attilabody/cardetector/hardware/kicad/328p-au/cardetector_328p-au.kicad_pcb

## KiCad design hardware/kicad/328p-au/cardetector_328p-au.kicad_pcb (2018-04-12)

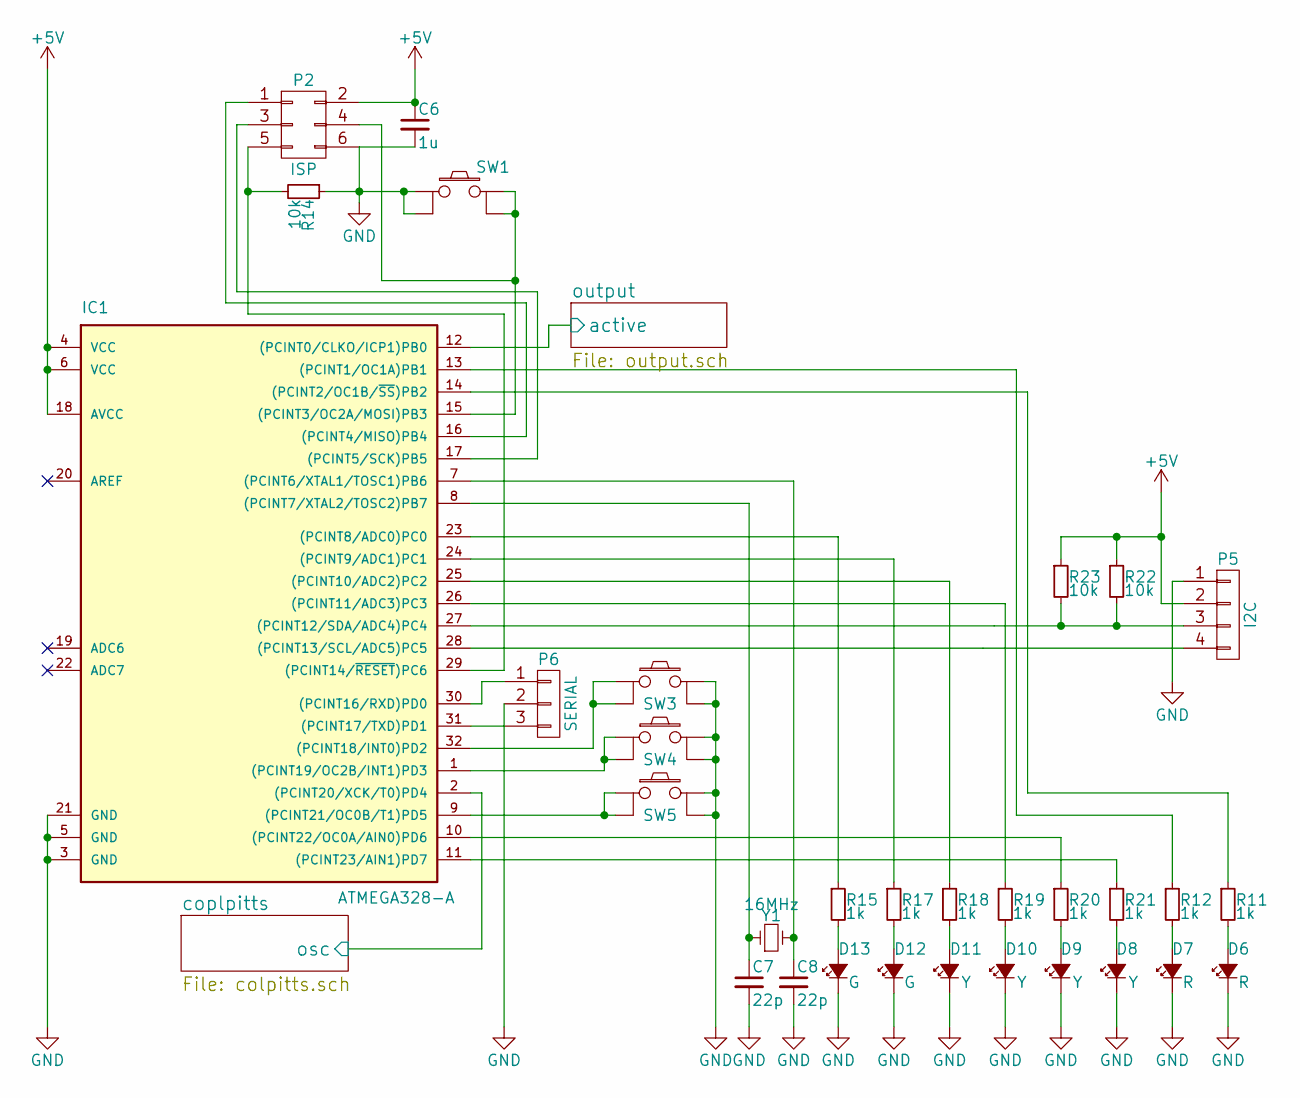
[picture p1: schematic cardetector_328p-au.sch]

Parts:
C6: 1u; C_0603_HandSoldering
C7, C8: 22p; C_0603_HandSoldering
D6, D7: R; SOD80C
D8, D9, D10, D11: Y; SOD80C
D12, D13: G; SOD80C
IC1: ATMEGA328-A; TQFP-32_7x7mm_Pitch0.8mm
P2: ISP; Socket_Strip_Straight_2x03
P5: I2C; Pin_Header_Straight_1x04
P6: SERIAL; Pin_Header_Straight_1x03
R11, R12, R15, R17, R18, R19, R20, R21: 1k; R_0603_HandSoldering
R14, R22, R23: 10k; R_0603_HandSoldering
SW1, SW3, SW4, SW5: TACTILE_SW; SW_TH_Tactile_Omron_B3F-10xx
Y1: 16MHz; Crystal_HC49-U_Vertical

Connections:
+5V: C6.1, IC1.4 (VCC), IC1.6 (VCC), IC1.18 (AVCC), P2.2, P5.2, R22.1, R23.1; also elsewhere on the board
/coplpitts/osc: IC1.2 ((PCINT20/XCK/T0)PD4); also elsewhere on the board
/output/active: IC1.12 ((PCINT0/CLKO/ICP1)PB0); also elsewhere on the board
GND: C6.2, C7.2, C8.2, D6.1 (K), D7.1 (K), D8.1 (K), D9.1 (K), D10.1 (K), D11.1 (K), D12.1 (K), D13.1 (K), IC1.3 (GND), IC1.5 (GND), IC1.21 (GND), P2.6, P5.1, P6.2, R14.1, SW1.1, SW1.2, SW3.3, SW3.4, SW4.3, SW4.4, SW5.3, SW5.4; also elsewhere on the board
unnamed: C7.1, IC1.8 ((PCINT7/XTAL2/TOSC2)PB7), Y1.1
unnamed: C8.1, IC1.7 ((PCINT6/XTAL1/TOSC1)PB6), Y1.2
unnamed: D6.2 (A), R11.2
unnamed: D7.2 (A), R12.2
unnamed: D8.2 (A), R21.2
unnamed: D9.2 (A), R20.2
unnamed: D10.2 (A), R19.2
unnamed: D11.2 (A), R18.2
unnamed: D12.2 (A), R17.2
unnamed: D13.2 (A), R15.2
unnamed: IC1.1 ((PCINT19/OC2B/INT1)PD3), SW4.1, SW4.2
unnamed: IC1.9 ((PCINT21/OC0B/T1)PD5), SW5.1, SW5.2
unnamed: IC1.10 ((PCINT22/OC0A/AIN0)PD6), R20.1
unnamed: IC1.11 ((PCINT23/AIN1)PD7), R21.1
unnamed: IC1.13 ((PCINT1/OC1A)PB1), R12.1
unnamed: IC1.14 ((PCINT2/OC1B/~SS~)PB2), R11.1
unnamed: IC1.16 ((PCINT4/MISO)PB4), P2.1
unnamed: IC1.17 ((PCINT5/SCK)PB5), P2.3
unnamed: IC1.23 ((PCINT8/ADC0)PC0), R15.1
unnamed: IC1.24 ((PCINT9/ADC1)PC1), R17.1
unnamed: IC1.25 ((PCINT10/ADC2)PC2), R18.1
unnamed: IC1.26 ((PCINT11/ADC3)PC3), R19.1
unnamed: IC1.27 ((PCINT12/SDA/ADC4)PC4), P5.3, R22.2, R23.2
unnamed: IC1.28 ((PCINT13/SCL/ADC5)PC5), P5.4
unnamed: IC1.30 ((PCINT16/RXD)PD0), P6.1
unnamed: IC1.31 ((PCINT17/TXD)PD1), P6.3
unnamed: IC1.32 ((PCINT18/INT0)PD2), SW3.1, SW3.2

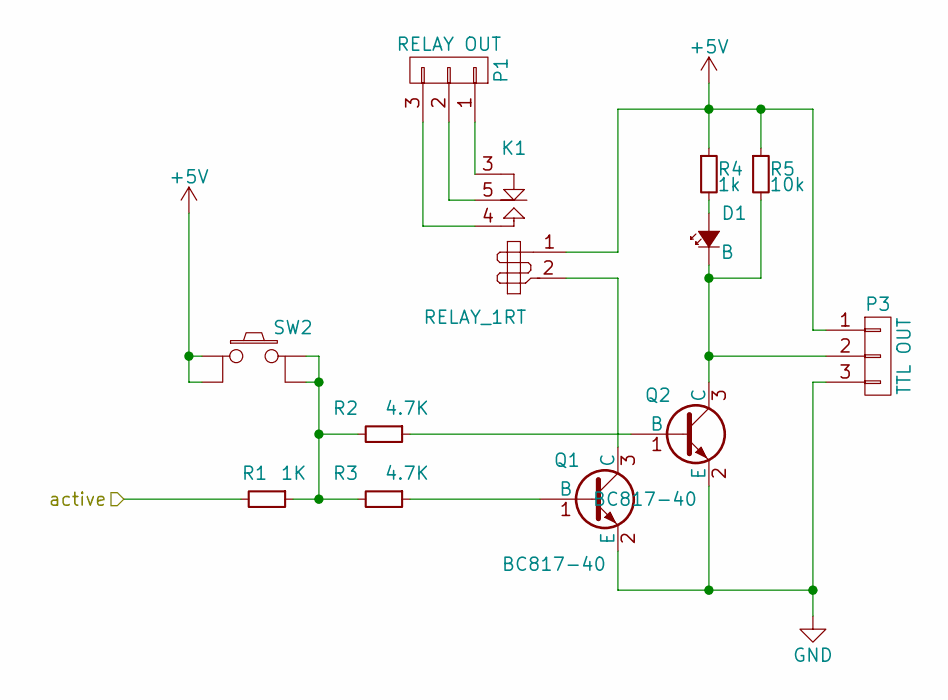
[picture p2: schematic output.sch]

Parts:
D1: B; SOD80C
K1: RELAY_1RT; SRD-SL-C
P1: RELAY OUT; W237-133
P3: TTL OUT; Pin_Header_Straight_1x03
Q1, Q2: BC817-40; SOT-23
R1: 1K; R_0603_HandSoldering
R2, R3: 4.7K; R_0603_HandSoldering
R4: 1k; R_0603_HandSoldering
R5: 10k; R_0603_HandSoldering
SW2: TACTILE_SW; SW_TH_Tactile_Omron_B3F-10xx

Connections:
+5V: K1.1, P3.1, R4.1, R5.1, SW2.1, SW2.2; also elsewhere on the board
/output/active: R1.2; also elsewhere on the board
GND: P3.3, Q1.2 (E), Q2.2 (E); also elsewhere on the board
unnamed: D1.1 (K), P3.2, Q2.3 (C), R5.2
unnamed: D1.2 (A), R4.2
unnamed: K1.2, Q1.3 (C)
unnamed: K1.3 (R1), P1.1
unnamed: K1.4 (T1), P1.3
unnamed: K1.5 (C1), P1.2
unnamed: Q1.1 (B), R3.1
unnamed: Q2.1 (B), R2.1
unnamed: R1.1, R2.2, R3.2, SW2.3, SW2.4

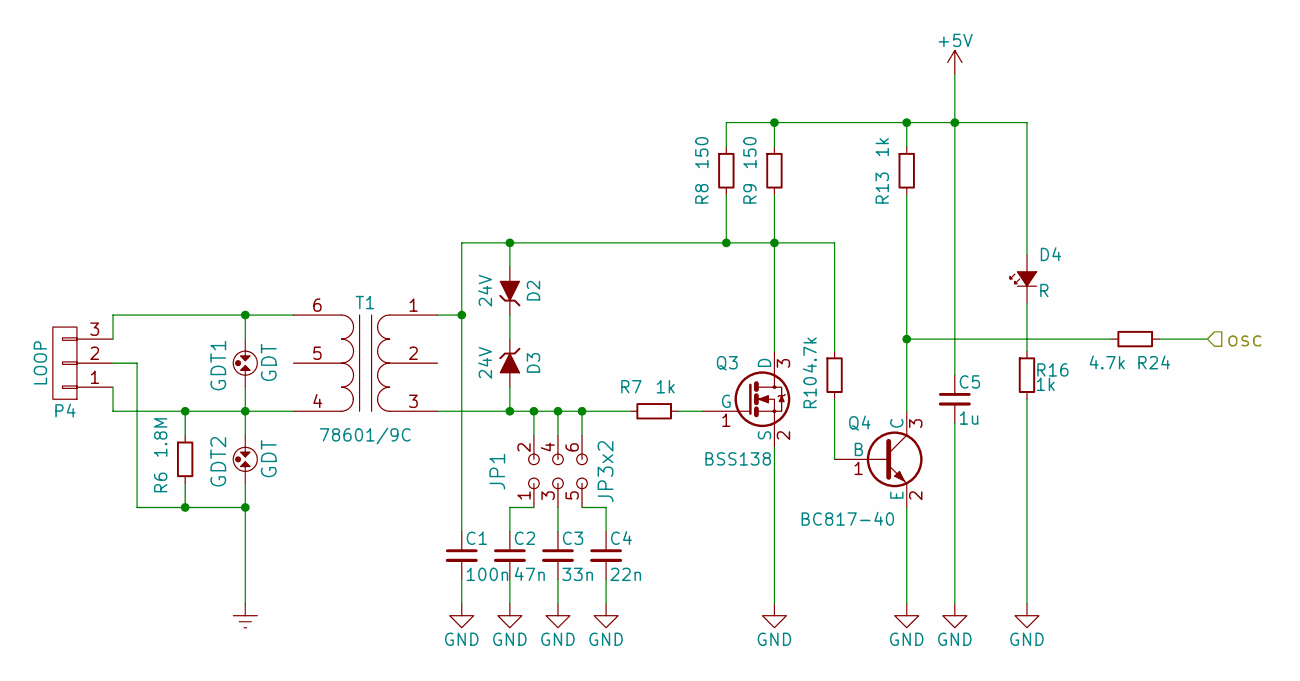
[picture p3: schematic colpitts.sch]

Parts:
C1: 100n; C_0603_HandSoldering
C2: 47n; C_0603_HandSoldering
C3: 33n; C_0603_HandSoldering
C4: 22n; C_0603_HandSoldering
C5: 1u; C_0603_HandSoldering
D2, D3: 24V; SOD80C
D4: R; SOD80C
GDT1, GDT2: GDT; CG5350L
JP1: JP3x2; Pin_Header_Straight_2x03
P4: LOOP; W237-133
Q3: BSS138; SOT-23
Q4: BC817-40; SOT-23
R6: 1.8M; R_0603_HandSoldering
R7, R13, R16: 1k; R_0603_HandSoldering
R8, R9: 150; R_0603_HandSoldering
R10, R24: 4.7k; R_0603_HandSoldering
T1: 78601/9C; 78601_9C

Connections:
+5V: C5.1, D4.2 (A), R8.1, R9.1, R13.1; also elsewhere on the board
/coplpitts/osc: R24.1; also elsewhere on the board
Earth: GDT2.2, P4.2, R6.2
GND: C1.2, C2.2, C3.2, C4.2, C5.2, Q3.2 (S), Q4.2 (E), R16.2; also elsewhere on the board
unnamed: C1.1, D2.2 (A), Q3.3 (D), R8.2, R9.2, R10.1, T1.1 (AA)
unnamed: C2.1, JP1.1
unnamed: C3.1, JP1.3
unnamed: C4.1, JP1.5
unnamed: D2.1 (K), D3.1 (K)
unnamed: D3.2 (A), JP1.2, JP1.4, JP1.6, R7.2, T1.3 (AB)
unnamed: D4.1 (K), R16.1
unnamed: GDT1.1, P4.3, T1.6 (SB)
unnamed: GDT1.2, GDT2.1, P4.1, R6.1, T1.4 (SA)
unnamed: Q3.1 (G), R7.1
unnamed: Q4.1 (B), R10.2
unnamed: Q4.3 (C), R13.2, R24.2

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
Board: 2 copper layers, 66 parts (2 on the bottom side), 55 nets, no tracks yet.
