attilabody/cardetector/hardware/kicad/stm32f030/stm32f030.kicad_pcb

## KiCad design hardware/kicad/stm32f030/stm32f030.kicad_pcb (2018-04-12)

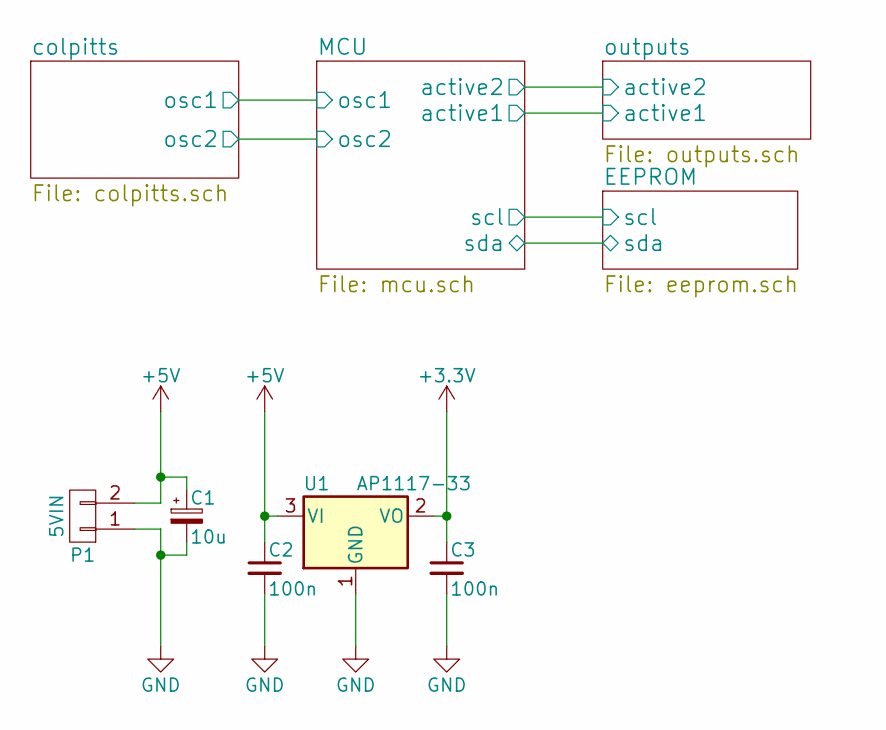
[picture p4: schematic stm32f030.sch]

Parts:
C1: 10u; Tantalum_Case-B_EIA-3528-21_Hand
C2, C3: 100n; C_0805_HandSoldering
P1: 5VIN; bornier2
U1: AP1117-33; SOT-223-3Lead_TabPin2

Connections:
+3V3: C3.1, U1.2 (VO); also elsewhere on the board
+5V: C1.1, C2.1, P1.2, U1.3 (VI); also elsewhere on the board
GND: C1.2, C2.2, C3.2, P1.1, U1.1 (GND); also elsewhere on the board

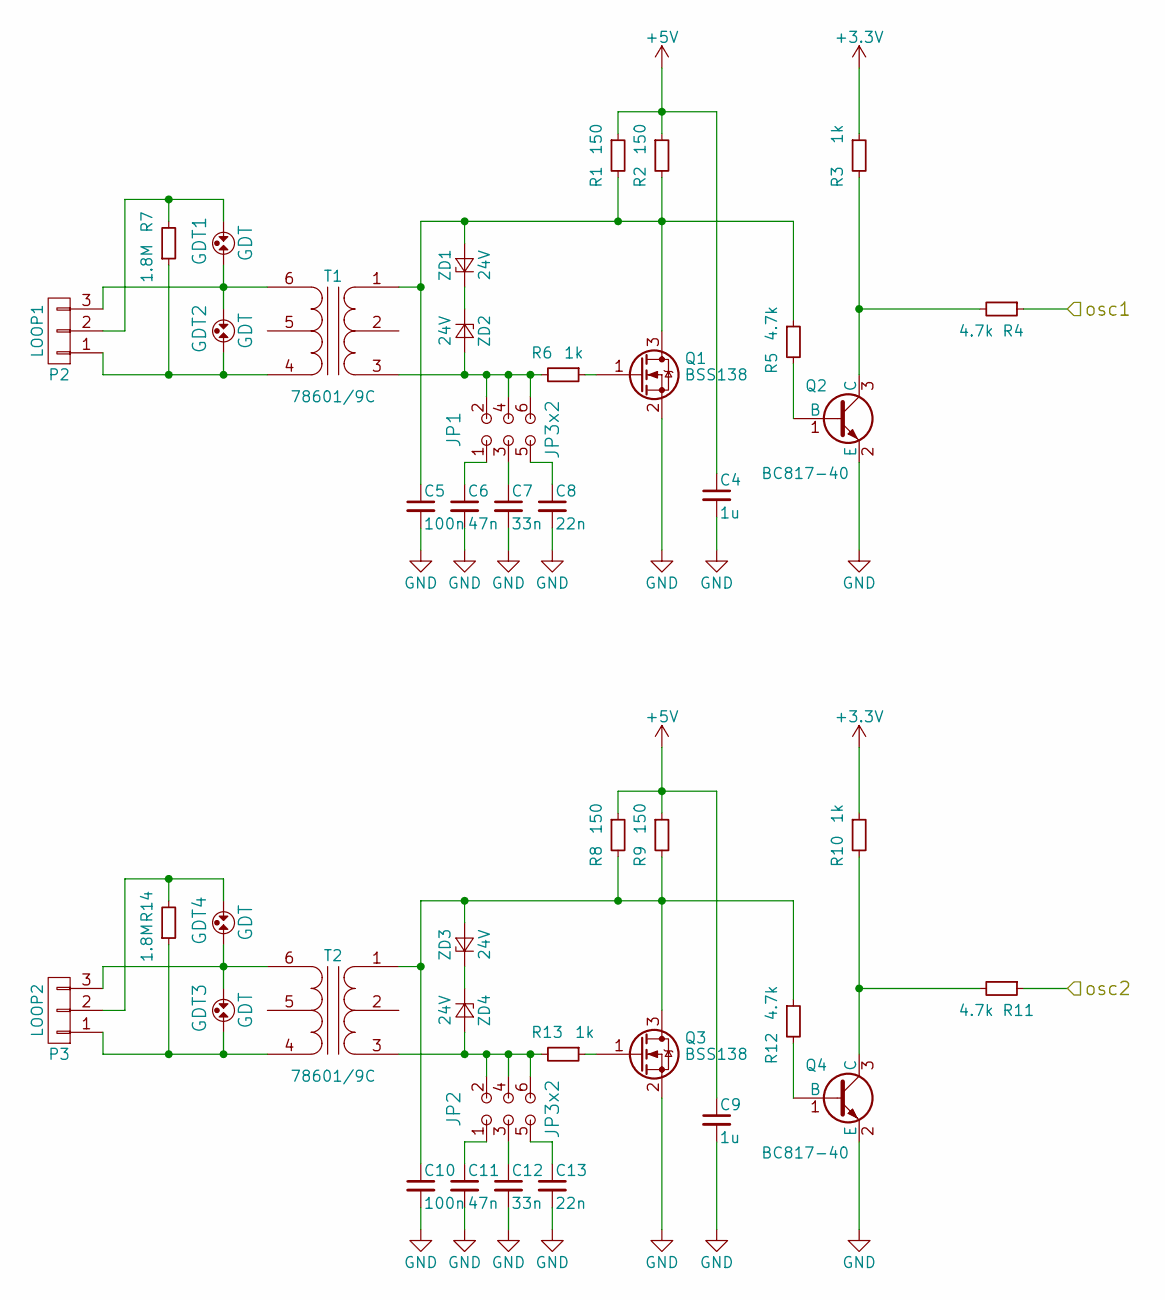
[picture p5: schematic colpitts.sch]

Parts:
C4, C9: 1u; C_1206_HandSoldering
C5, C10: 100n; C_1206_HandSoldering
C6, C11: 47n; C_1206
C7, C12: 33n; C_0805_HandSoldering
C8, C13: 22n; C_0805_HandSoldering
GDT1, GDT2, GDT3, GDT4: GDT
JP1, JP2: JP3x2; Pin_Header_Straight_2x03_Pitch2.54mm
P2: LOOP1; bornier3
P3: LOOP2; bornier3
Q1, Q3: BSS138; SOT-23
Q2, Q4: BC817-40; SOT-23
R1, R2, R8, R9: 150; R_0805
R3, R6, R10, R13: 1k; R_0603_HandSoldering
R4, R5, R11, R12: 4.7k; R_0603_HandSoldering
R7, R14: 1.8M; R_0603_HandSoldering
T1, T2: 78601/9C; Murata_Impulse_Transformer
ZD1, ZD2, ZD3, ZD4: 24V; D_MiniMELF_Standard

Connections:
+3V3: R3.1, R10.1; also elsewhere on the board
+5V: C4.1, C9.1, R1.1, R2.1, R8.1, R9.1; also elsewhere on the board
/MCU/osc1: R4.1; also elsewhere on the board
/MCU/osc2: R11.1; also elsewhere on the board
GND: C4.2, C5.2, C6.2, C7.2, C8.2, C9.2, C10.2, C11.2, C12.2, C13.2, Q1.2 (S), Q2.2 (E), Q3.2 (S), Q4.2 (E); also elsewhere on the board
unnamed: C5.1, Q1.3 (D), R1.2, R2.2, R5.1, T1.1 (AA), ZD1.2 (A)
unnamed: C6.1, JP1.1
unnamed: C7.1, JP1.3
unnamed: C8.1, JP1.5
unnamed: C10.1, Q3.3 (D), R8.2, R9.2, R12.1, T2.1 (AA), ZD3.2 (A)
unnamed: C11.1, JP2.1
unnamed: C12.1, JP2.3
unnamed: C13.1, JP2.5
unnamed: GDT1.1, GDT2.2, P2.3, T1.6 (SB)
unnamed: GDT1.2, P2.2, R7.2
unnamed: GDT2.1, P2.1, R7.1, T1.4 (SA)
unnamed: GDT3.1, P3.1, R14.1, T2.4 (SA)
unnamed: GDT3.2, GDT4.1, P3.3, T2.6 (SB)
unnamed: GDT4.2, P3.2, R14.2
unnamed: JP1.2, JP1.4, JP1.6, R6.2, T1.3 (AB), ZD2.2 (A)
unnamed: JP2.2, JP2.4, JP2.6, R13.2, T2.3 (AB), ZD4.2 (A)
unnamed: Q1.1 (G), R6.1
unnamed: Q2.1 (B), R5.2
unnamed: Q2.3 (C), R3.2, R4.2
unnamed: Q3.1 (G), R13.1
unnamed: Q4.1 (B), R12.2
unnamed: Q4.3 (C), R10.2, R11.2
unnamed: ZD1.1 (K), ZD2.1 (K)
unnamed: ZD3.1 (K), ZD4.1 (K)

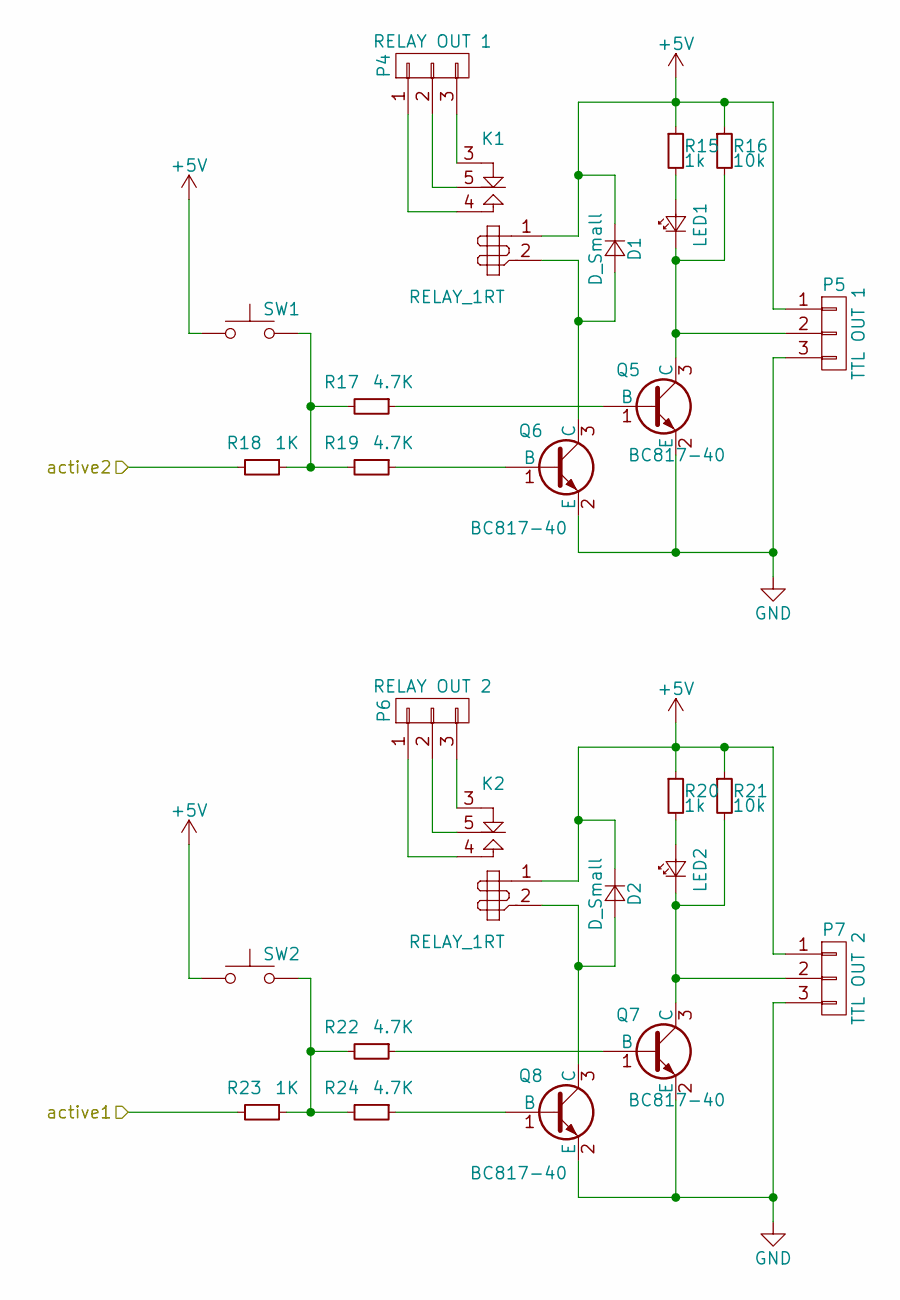
[picture p6: schematic outputs.sch]

Parts:
D1, D2: D_Small; D_MiniMELF_Standard
K1, K2: RELAY_1RT; SRD-SL-C
LED1, LED2: LED_Small; LED_0805
P4: RELAY OUT 1; bornier3
P5: TTL OUT 1; Pin_Header_Straight_1x03_Pitch2.54mm
P6: RELAY OUT 2; bornier3
P7: TTL OUT 2; Pin_Header_Straight_1x03_Pitch2.54mm
Q5, Q6, Q7, Q8: BC817-40; SOT-23_Handsoldering
R15, R20: 1k; R_0603_HandSoldering
R16, R21: 10k; R_0603_HandSoldering
R17, R19, R22, R24: 4.7K; R_0603_HandSoldering
R18, R23: 1K; R_0603_HandSoldering
SW1, SW2: SW_Push; TS_362

Connections:
+5V: D1.1 (K), D2.1 (K), K1.1, K2.1, P5.1, P7.1, R15.1, R16.1, R20.1, R21.1, SW1.1, SW2.1; also elsewhere on the board
/MCU/active1: R23.2; also elsewhere on the board
/MCU/active2: R18.2; also elsewhere on the board
GND: P5.3, P7.3, Q5.2 (E), Q6.2 (E), Q7.2 (E), Q8.2 (E); also elsewhere on the board
unnamed: D1.2 (A), K1.2, Q6.3 (C)
unnamed: D2.2 (A), K2.2, Q8.3 (C)
unnamed: K1.3 (R1), P4.3
unnamed: K1.4 (T1), P4.1
unnamed: K1.5 (C1), P4.2
unnamed: K2.3 (R1), P6.3
unnamed: K2.4 (T1), P6.1
unnamed: K2.5 (C1), P6.2
unnamed: LED1.1 (K), P5.2, Q5.3 (C), R16.2
unnamed: LED1.2 (A), R15.2
unnamed: LED2.1 (K), P7.2, Q7.3 (C), R21.2
unnamed: LED2.2 (A), R20.2
unnamed: Q5.1 (B), R17.1
unnamed: Q6.1 (B), R19.1
unnamed: Q7.1 (B), R22.1
unnamed: Q8.1 (B), R24.1
unnamed: R17.2, R18.1, R19.2, SW1.2
unnamed: R22.2, R23.1, R24.2, SW2.2

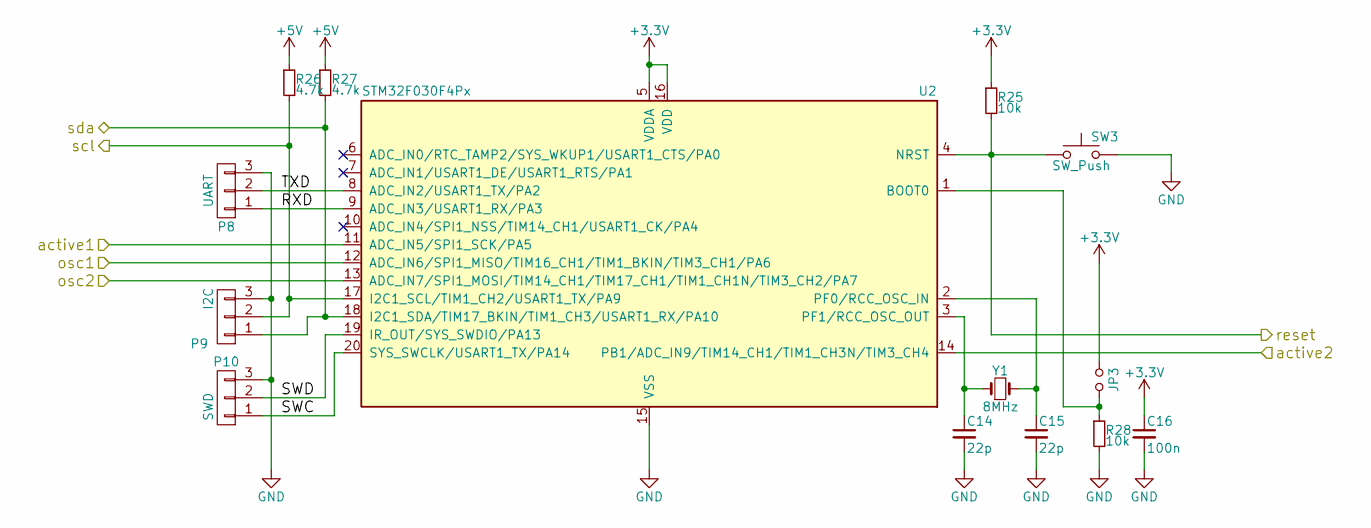
[picture p7: schematic mcu.sch]

Parts:
C14, C15: 22p; C_0603_HandSoldering
C16: 100n; C_0805_HandSoldering
JP3: boot0; Pin_Header_Straight_1x02_Pitch2.54mm
P8: UART; Pin_Header_Straight_1x03_Pitch2.54mm
P9: I2C; Pin_Header_Straight_1x03_Pitch2.54mm
P10: SWD; Pin_Header_Straight_1x03_Pitch2.54mm
R25, R28: 10k; R_0603_HandSoldering
R26, R27: 4.7k; R_0603_HandSoldering
SW3: SW_Push; TS_362
U2: STM32F030F4Px; TSSOP-20_4.4x6.5mm_Pitch0.65mm_Handsoldering
Y1: 8MHz; Crystal_HC49-4H_Vertical

Connections:
+3V3: C16.1, JP3.1, R25.1, U2.5 (VDDA), U2.16 (VDD); also elsewhere on the board
+5V: R26.1, R27.1; also elsewhere on the board
/EEPROM/scl: P9.2, R26.2, U2.17 (I2C1_SCL/TIM1_CH2/USART1_TX/PA9); also elsewhere on the board
/EEPROM/sda: P9.1, R27.2, U2.18 (I2C1_SDA/TIM17_BKIN/TIM1_CH3/USART1_RX/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); also elsewhere on the board
/MCU/RXD: P8.1, U2.9 (ADC_IN3/USART1_RX/PA3)
/MCU/SWC: P10.1, U2.20 (SYS_SWCLK/USART1_TX/PA14)
/MCU/SWD: P10.2, U2.19 (IR_OUT/SYS_SWDIO/PA13)
/MCU/TXD: P8.2, U2.8 (ADC_IN2/USART1_TX/PA2)
/MCU/active1: U2.11 (ADC_IN5/SPI1_SCK/PA5); also elsewhere on the board
/MCU/active2: U2.14 (PB1/ADC_IN9/TIM14_CH1/TIM1_CH3N/TIM3_CH4); also elsewhere on the board
/MCU/osc1: U2.12 (ADC_IN6/SPI1_MISO/TIM16_CH1/TIM1_BKIN/T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); also elsewhere on the board
/MCU/osc2: U2.13 (ADC_IN7/SPI1_MOSI/TIM14_CH1/TIM17_CH1/T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); also elsewhere on the board
/MCU/reset: R25.2, SW3.1, U2.4 (NRST)
GND: C14.2, C15.2, C16.2, P8.3, P9.3, P10.3, R28.2, SW3.2, U2.15 (VSS); also elsewhere on the board
unnamed: C14.1, U2.3 (PF1/RCC_OSC_OUT), Y1.1
unnamed: C15.1, U2.2 (PF0/RCC_OSC_IN), Y1.2
unnamed: JP3.2, R28.1, U2.1 (BOOT0)

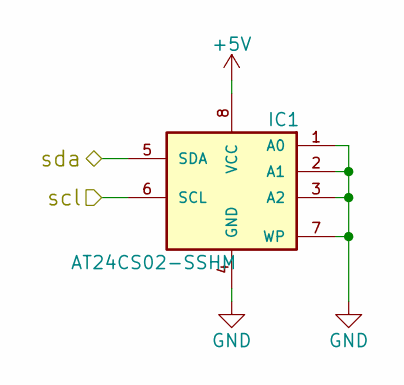
[picture p8: schematic eeprom.sch]

Parts:
IC1: AT24CS02-SSHM; SOIC-8_3.9x4.9mm_Pitch1.27mm

Connections:
+5V: IC1.8 (VCC); also elsewhere on the board
/EEPROM/scl: IC1.6 (SCL); also elsewhere on the board
/EEPROM/sda: IC1.5 (SDA); also elsewhere on the board
GND: IC1.1 (A0), IC1.2 (A1), IC1.3 (A2), IC1.4 (GND), IC1.7 (WP); also elsewhere on the board

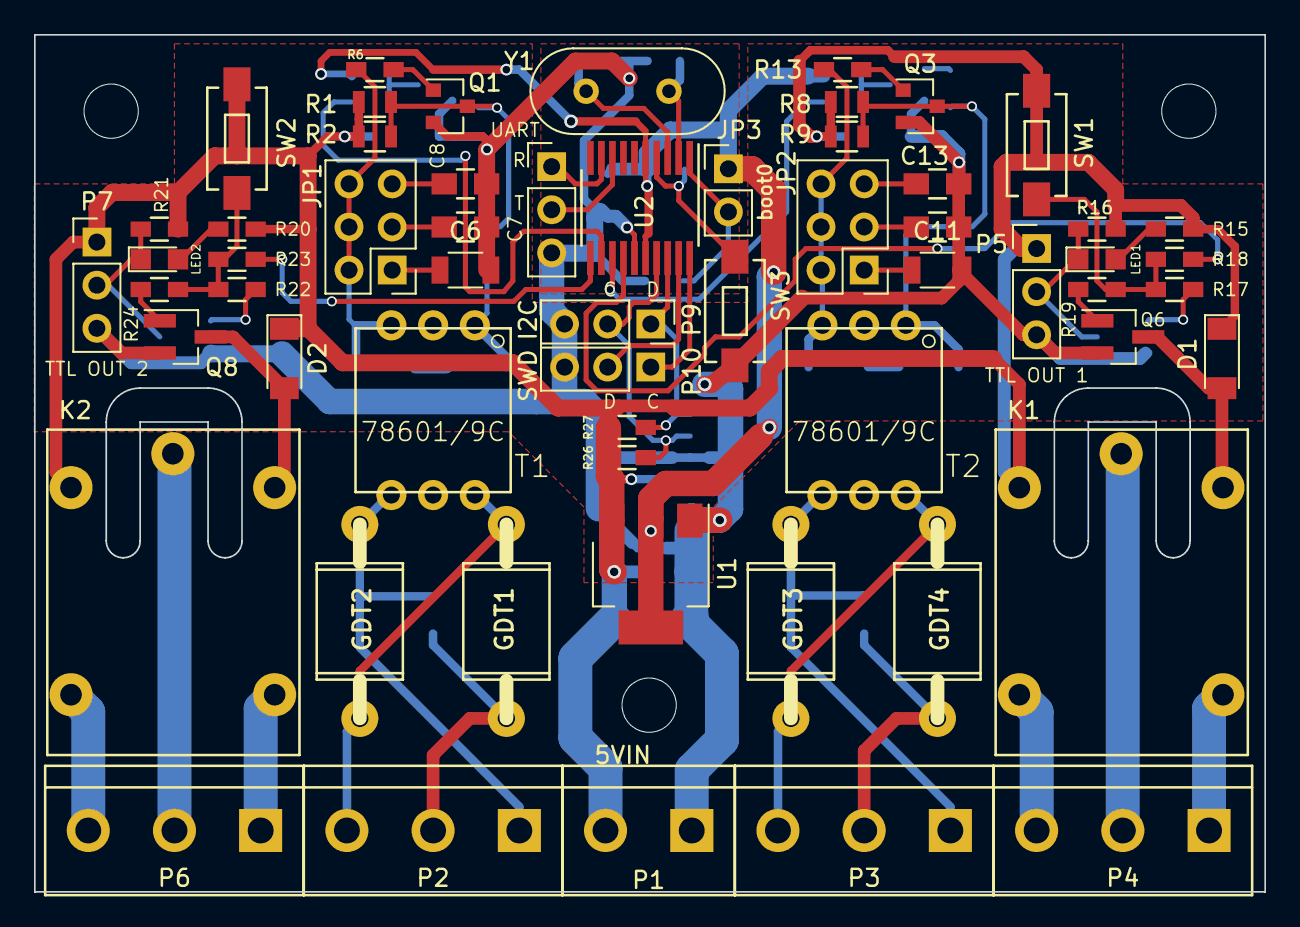
[picture p9: board stm32f030.kicad_pcb from above]

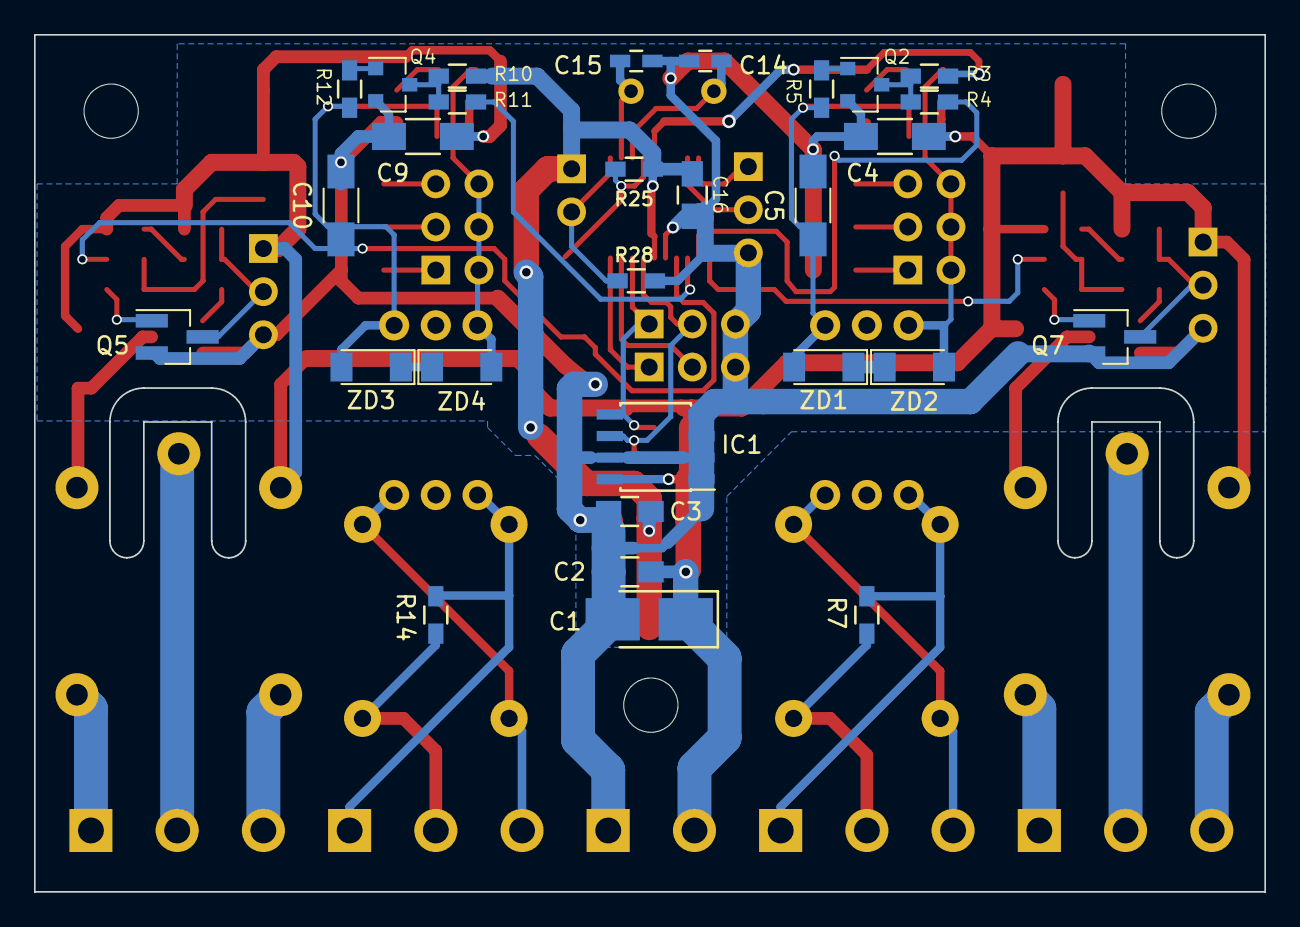
[picture p10: board stm32f030.kicad_pcb from below]

Board: 2 copper layers, 72.5 x 50.5 mm, 88 parts (29 on the bottom side), 59 nets.
