attilabody/cardetector/hardware/eagle/detector328p-pu.brd

## EAGLE design hardware/eagle/detector328p-pu.brd (2018-04-12)

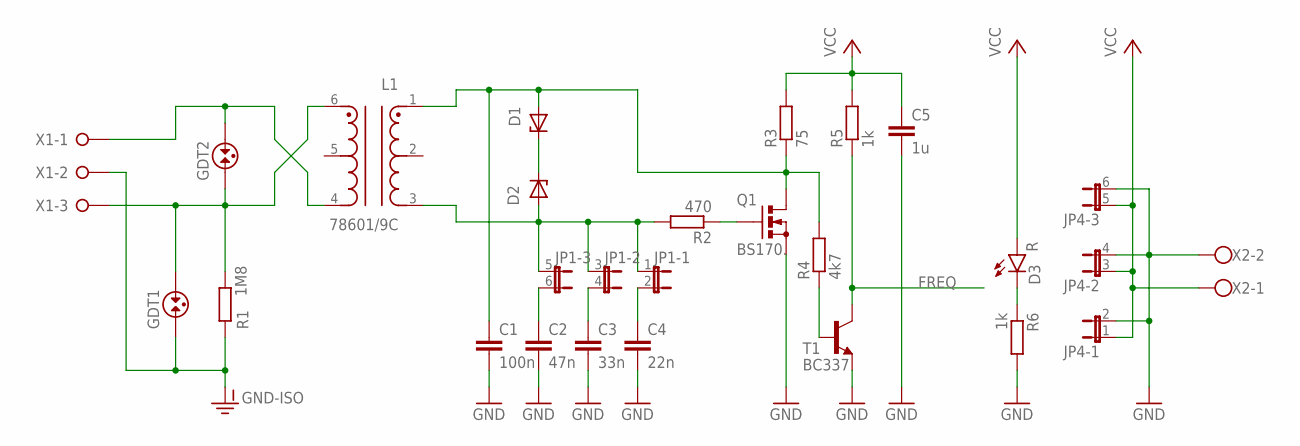
[picture p11: schematic detector328p-pu.sch, sheet 1]

Parts:
C1: 100n; C025-025X050
C2: 47n; C025-025X050
C3: 33n; C025-025X050
C4: 22n; C025-025X050
C5: 1u; C025-030X050
D1, D2: 24V; ZDIO-5
D3: R; LED3MM
GDT1, GDT2: GDT-CG5350L; CG5350L
JP1, JP4: JP3QE; JP3Q
L1: 78601/9C
Q1: BS170.; TO92-DGS
R1: 1M8; 0204/5
R2: 470; 0204/5
R3: 75; 0204/7
R4: 4k7; 0204/5
R5, R6: 1k; 0204/5
T1: BC337; TO92-CBE
X1: W237-03P; W237-133
X2: W237-102

Connections:
FREQ: R5.1, T1.C; also elsewhere on the board
GND: C1.2, C2.2, C3.2, C4.2, C5.2, JP4.2, JP4.4 (2), JP4.6 (2), Q1.S, R6.2, T1.E, X2.2; also elsewhere on the board
GND-ISO: GDT1.1, R1.1, X1.2
unnamed: D1.C, D2.C
unnamed: R4.1, T1.B
unnamed: Q1.G, R2.1
unnamed: C3.1, JP1.4 (2)
unnamed: C4.1, JP1.2
unnamed: D2.A, JP1.1, JP1.3 (1), JP1.5 (1), L1.3, R2.2
unnamed: GDT2.2, L1.4, X1.1
unnamed: C2.1, JP1.6 (2)
unnamed: C1.1, D1.A, L1.1, Q1.D, R3.1, R4.2
unnamed: D3.K (C), R6.1
unnamed: GDT1.2, GDT2.1, L1.6, R1.2, X1.3
VCC: C5.1, D3.A, JP4.1, JP4.3 (1), JP4.5 (1), R3.2, R5.2, X2.1; also elsewhere on the board

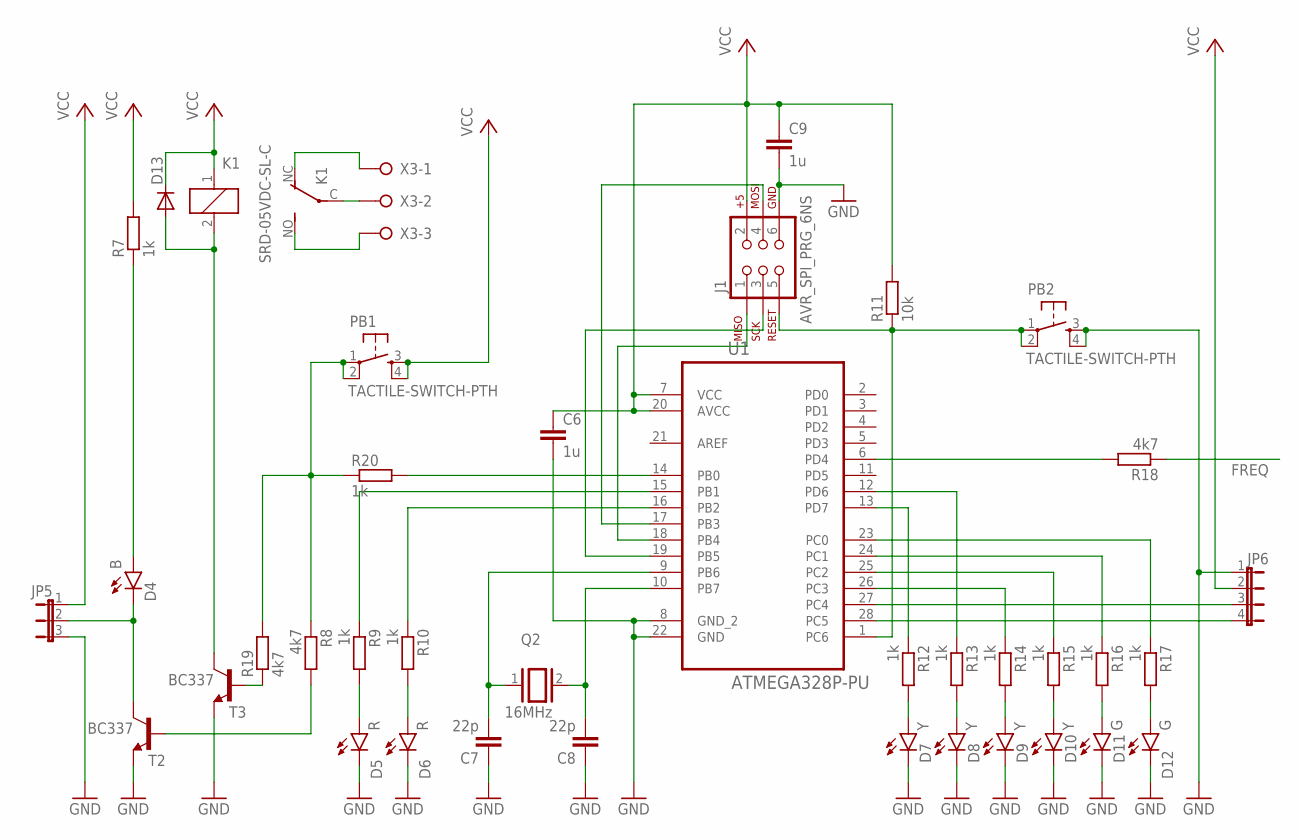
[picture p12: schematic detector328p-pu.sch, sheet 2]

Parts:
C6, C9: 1u; C025-030X050
C7, C8: 22p; C025-025X050
D4: B; LED3MM
D5, D6: R; LED3MM
D7, D8, D9, D10: Y; LED3MM
D11, D12: G; LED3MM
D13: DIODE-D-5; D-5
J1: AVR_SPI_PRG_6NS; 2X3-NS
JP5: JP2E; JP2
JP6: JP4E; JP4
K1: SRD-05VDC-SL-C; JS-M
PB1, PB2: TACTILE-SWITCH-PTH; TAC-SWITCH-PTH
Q2: 16MHz; QS
R7, R9, R10, R12, R13, R14, R15, R16, R17, R20: 1k; 0204/5
R8, R18, R19: 4k7; 0204/5
R11: 10k; 0204/5
T2, T3: BC337; TO92-CBE
U1: ATMEGA328P-PU; DIP254P762X457-28
X3: W237-03P; W237-133

Connections:
FREQ: R18.1; also elsewhere on the board
GND: C6.2, C7.1, C8.1, C9.2, D5.K (C), D6.K (C), D7.K (C), D8.K (C), D9.K (C), D10.K (C), D11.K (C), D12.K (C), J1.6, JP5.3, JP6.1, PB2.3, PB2.4, T2.E, T3.E, U1.8 (GND_2), U1.22 (GND); also elsewhere on the board
unnamed: C7.2, Q2.1, U1.9 (PB6)
unnamed: R18.2, U1.6 (PD4)
unnamed: C8.2, Q2.2, U1.10 (PB7)
unnamed: J1.1, U1.18 (PB4)
unnamed: J1.4, U1.17 (PB3)
unnamed: J1.3, U1.19 (PB5)
unnamed: D8.A, R13.2
unnamed: D9.A, R14.2
unnamed: D10.A, R15.2
unnamed: D11.A, R16.2
unnamed: R8.2, T2.B
unnamed: R20.2, U1.14 (PB0)
unnamed: D4.K (C), JP5.2, T2.C
unnamed: D4.A, R7.1
unnamed: R13.1, U1.12 (PD6)
unnamed: R12.1, U1.13 (PD7)
unnamed: D7.A, R12.2
unnamed: R14.1, U1.26 (PC3)
unnamed: R15.1, U1.25 (PC2)
unnamed: JP6.4, U1.28 (PC5)
unnamed: R16.1, U1.24 (PC1)
unnamed: D12.A, R17.2
unnamed: R17.1, U1.23 (PC0)
unnamed: D6.A, R10.2
unnamed: D5.A, R9.2
unnamed: R10.1, U1.16 (PB2)
unnamed: R9.1, U1.15 (PB1)
unnamed: PB1.1, PB1.2, R8.1, R19.2, R20.1
unnamed: D13.A, K1.2, T3.C
unnamed: R19.1, T3.B
unnamed: K1.NC (O), X3.1
unnamed: K1.NO (S), X3.3
unnamed: K1.C, X3.2
unnamed: J1.5, PB2.1, PB2.2, R11.1, U1.1 (PC6)
unnamed: JP6.3, U1.27 (PC4)
VCC: C6.1, C9.1, D13.C, J1.2, JP5.1, JP6.2, K1.1, PB1.3, PB1.4, R7.2, R11.2, U1.7 (VCC), U1.20 (AVCC); also elsewhere on the board

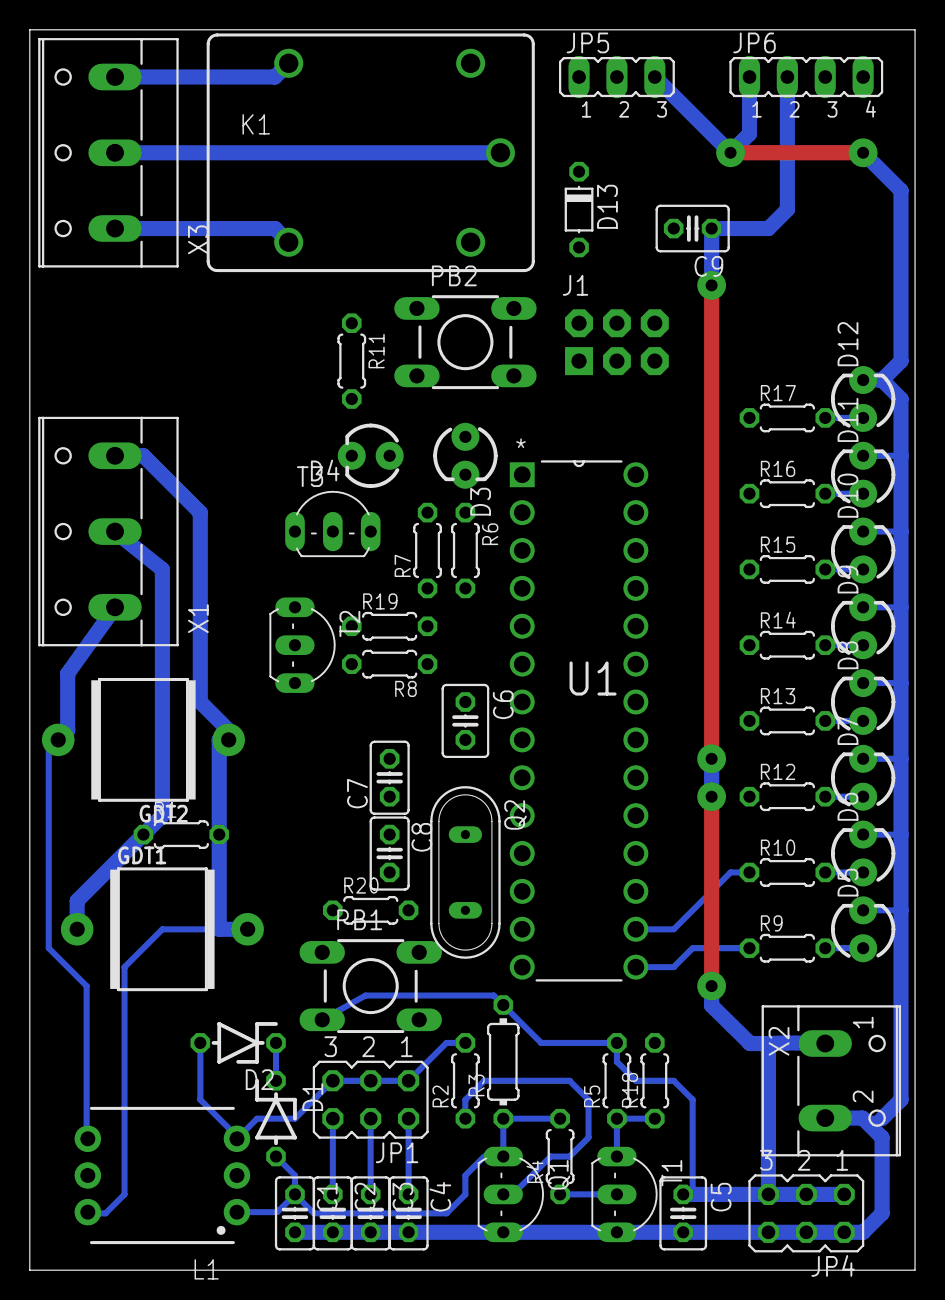
[picture p13: board detector328p-pu.brd from above]

Board: 2 copper layers, 59.4 x 83.2 mm, 62 parts (0 on the bottom side), 50 nets.
