attilabody/cardetector/hardware/eagle/detector328p-au.brd

## EAGLE design hardware/eagle/detector328p-au.brd (2018-04-12)

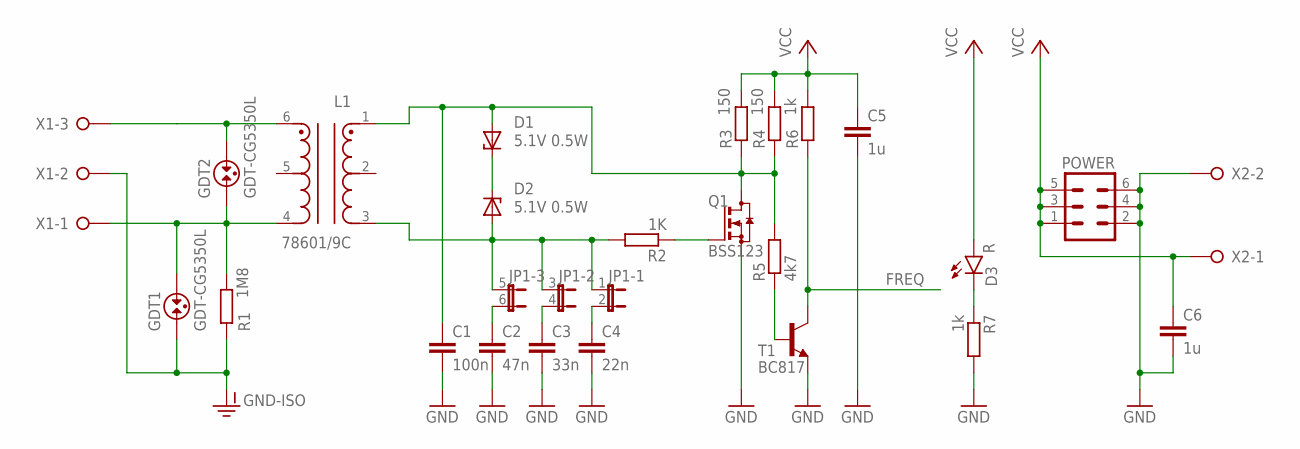
[picture p14: schematic detector328p-au.sch, sheet 1]

Parts:
C1: 100n; C0603
C2: 47n; C0603
C3: 33n; C0603
C4: 22n; C0603
C5, C6: 1u; C0603
D1, D2: 5.1V 0.5W; SOD80C
D3: R; LED-0603
GDT1, GDT2: GDT-CG5350L; CG5350L
JP1: JP3QE; JP3Q
L1: 78601/9C
POWER: MA03-2
Q1: BSS123; SOT23
R1: 1M8; R0603
R2: 1K; R0603
R3, R4: 150; R0603
R5: 4k7; R0603
R6, R7: 1k; R0603
T1: BC817; SOT23-BEC
X1: W237-3E
X2: W237-02P; W237-132

Connections:
FREQ: R6.1, T1.C; also elsewhere on the board
GND: C1.2, C2.2, C3.2, C4.2, C5.2, C6.2, POWER.2, POWER.4, POWER.6, Q1.2 (S), R7.2, T1.E, X2.2; also elsewhere on the board
GND-ISO: GDT1.1, R1.1, X1.2
unnamed: D1.C, D2.C
unnamed: R5.1, T1.B
unnamed: Q1.1 (G), R2.1
unnamed: C3.1, JP1.4 (2)
unnamed: C4.1, JP1.2
unnamed: D2.A, JP1.1, JP1.3 (1), JP1.5 (1), L1.3, R2.2
unnamed: GDT2.2, L1.6, X1.3
unnamed: C2.1, JP1.6 (2)
unnamed: C1.1, D1.A, L1.1, Q1.3 (D), R3.1, R4.1, R5.2
unnamed: GDT1.2, GDT2.1, L1.4, R1.2, X1.1
unnamed: D3.C, R7.1
VCC: C5.1, C6.1, D3.A, POWER.1, POWER.3, POWER.5, R3.2, R4.2, R6.2, X2.1; also elsewhere on the board

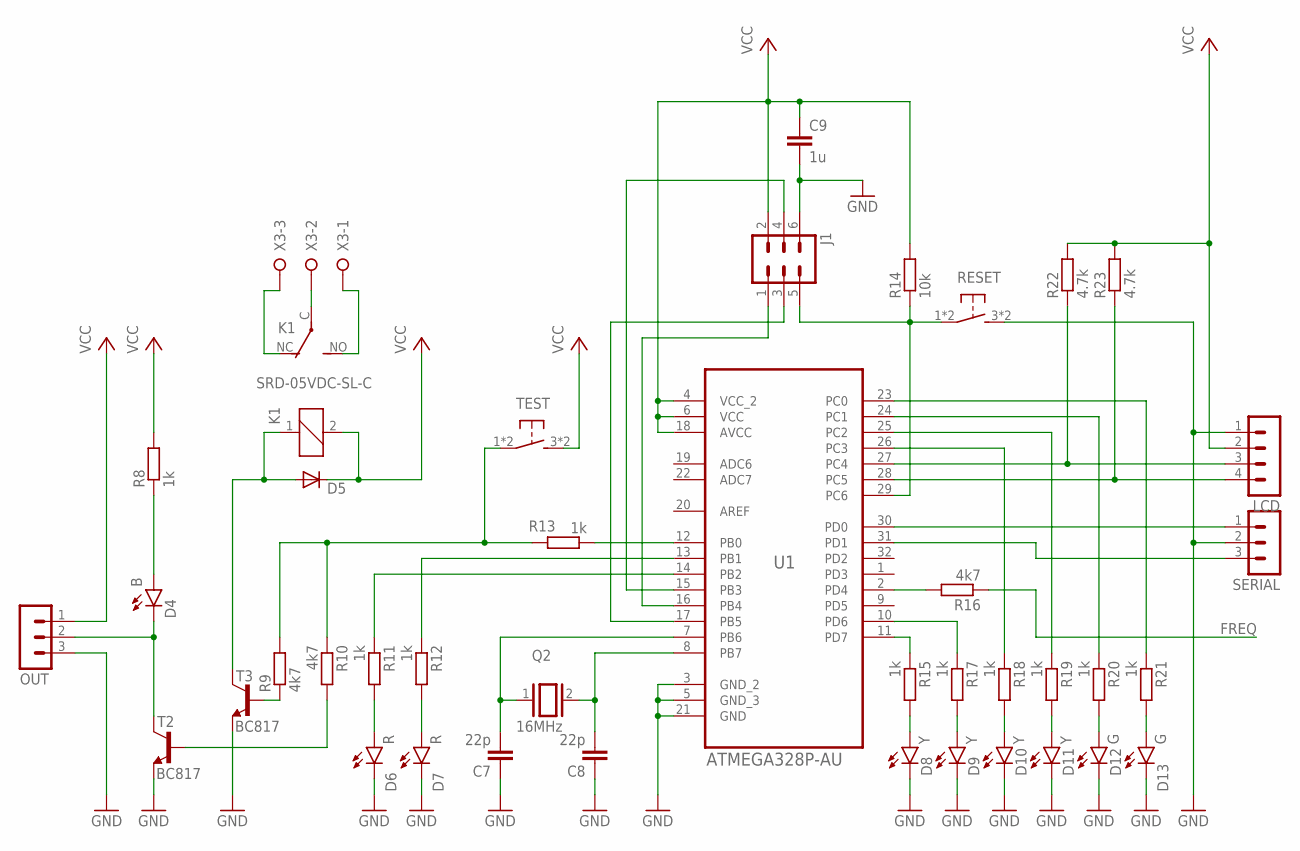
[picture p15: schematic detector328p-au.sch, sheet 2]

Parts:
C7, C8: 22p; C0603
C9: 1u; C0603
D4: B; LED-0603
D5: DIODE-SOD80C; SOD80C
D6, D7: R; LED-0603
D8, D9, D10, D11: Y; LED-0603
D12, D13: G; LED-0603
J1: MA03-2
K1: SRD-05VDC-SL-C; JS-M
LCD: MA04-1
OUT: MA03-1
Q2: 16MHz; QS
R8, R11, R12, R13, R15, R17, R18, R19, R20, R21: 1k; R0603
R9, R10, R16: 4k7; R0603
R14: 10k; R0603
R22, R23: 4.7k; R0603
RESET: 10-XX; B3F-10XX
SERIAL: MA03-1
T2, T3: BC817; SOT23-BEC
TEST: 10-XX; B3F-10XX
U1: ATMEGA328P-AU; QFP80P900X900X120-32N
X3: W237-3E

Connections:
FREQ: R16.1; also elsewhere on the board
GND: C7.1, C8.1, C9.2, D6.C, D7.C, D8.C, D9.C, D10.C, D11.C, D12.C, D13.C, J1.6, LCD.1, OUT.3, RESET.3 (S), RESET.4 (S), SERIAL.2, T2.E, T3.E, U1.3 (GND_2), U1.5 (GND_3), U1.21 (GND); also elsewhere on the board
unnamed: C7.2, Q2.1, U1.7 (PB6)
unnamed: R16.2, U1.2 (PD4)
unnamed: C8.2, Q2.2, U1.8 (PB7)
unnamed: J1.1, U1.16 (PB4)
unnamed: J1.4, U1.15 (PB3)
unnamed: J1.3, U1.17 (PB5)
unnamed: D9.A, R17.2
unnamed: D10.A, R18.2
unnamed: D11.A, R19.2
unnamed: D12.A, R20.2
unnamed: R10.2, T2.B
unnamed: D4.C, OUT.2, T2.C
unnamed: D4.A, R8.1
unnamed: R17.1, U1.10 (PD6)
unnamed: R15.1, U1.11 (PD7)
unnamed: D8.A, R15.2
unnamed: R18.1, U1.26 (PC3)
unnamed: R19.1, U1.25 (PC2)
unnamed: J1.5, R14.1, RESET.1, RESET.2, U1.29 (PC6)
unnamed: R20.1, U1.24 (PC1)
unnamed: D13.A, R21.2
unnamed: R21.1, U1.23 (PC0)
unnamed: D7.A, R12.2
unnamed: D6.A, R11.2
unnamed: R11.1, U1.14 (PB2)
unnamed: R12.1, U1.13 (PB1)
unnamed: D5.A, K1.1, T3.C
unnamed: SERIAL.1, U1.30 (PD0)
unnamed: R9.1, T3.B
unnamed: K1.NC (O), X3.3
unnamed: K1.NO (S), X3.1
unnamed: K1.C, X3.2
unnamed: LCD.4, R23.1, U1.28 (PC5)
unnamed: LCD.3, R22.1, U1.27 (PC4)
unnamed: R13.1, U1.12 (PB0)
unnamed: R9.2, R10.1, R13.2, TEST.1, TEST.2
unnamed: SERIAL.3, U1.31 (PD1)
VCC: C9.1, D5.C, J1.2, K1.2, LCD.2, OUT.1, R8.2, R14.2, R22.2, R23.2, TEST.3 (S), TEST.4 (S), U1.4 (VCC_2), U1.6 (VCC), U1.18 (AVCC); also elsewhere on the board

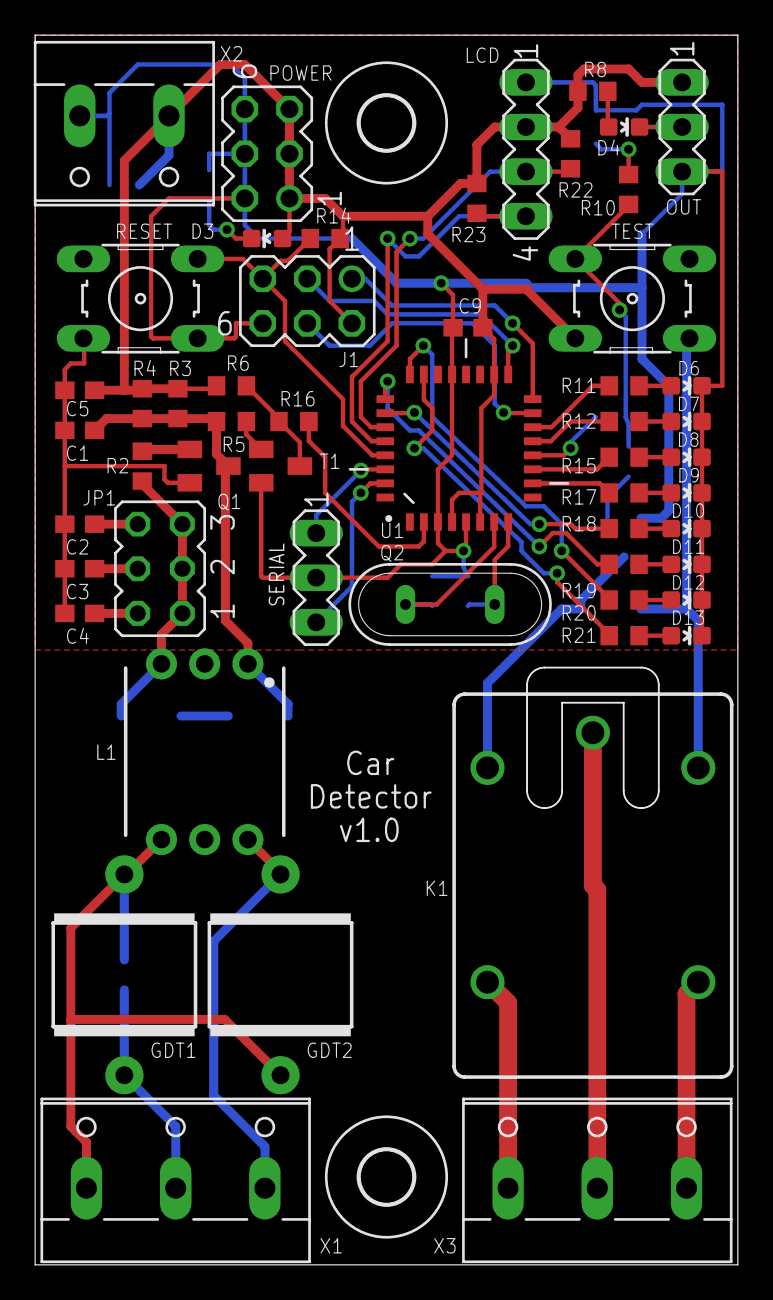
[picture p16: board detector328p-au.brd from above]

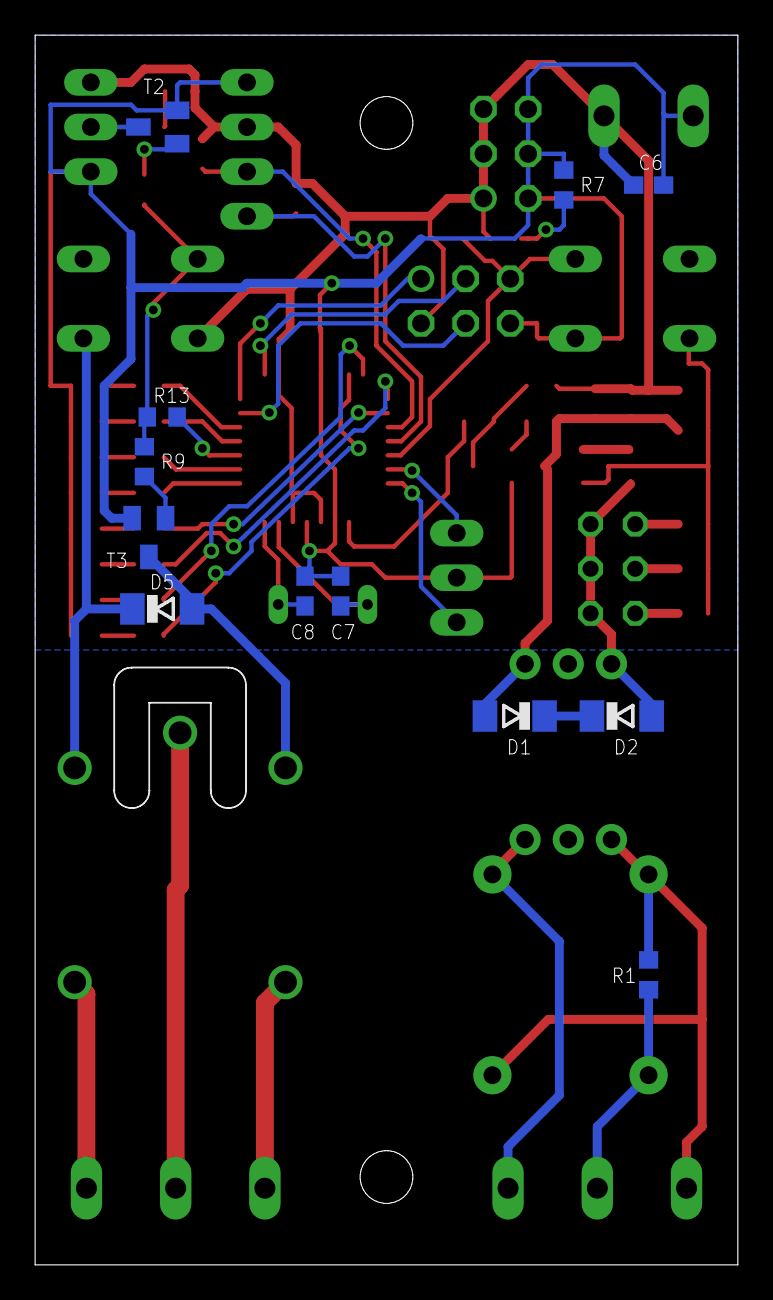
[picture p17: board detector328p-au.brd from below]

Board: 2 copper layers, 40.0 x 70.0 mm, 68 parts (12 on the bottom side), 52 nets.

Other parts of the board:
U$1, U$2: 3,0
