attilabody/cardetector/hardware/eagle/detector_t85-pu.brd

## EAGLE design hardware/eagle/detector_t85-pu.brd (2018-04-12)

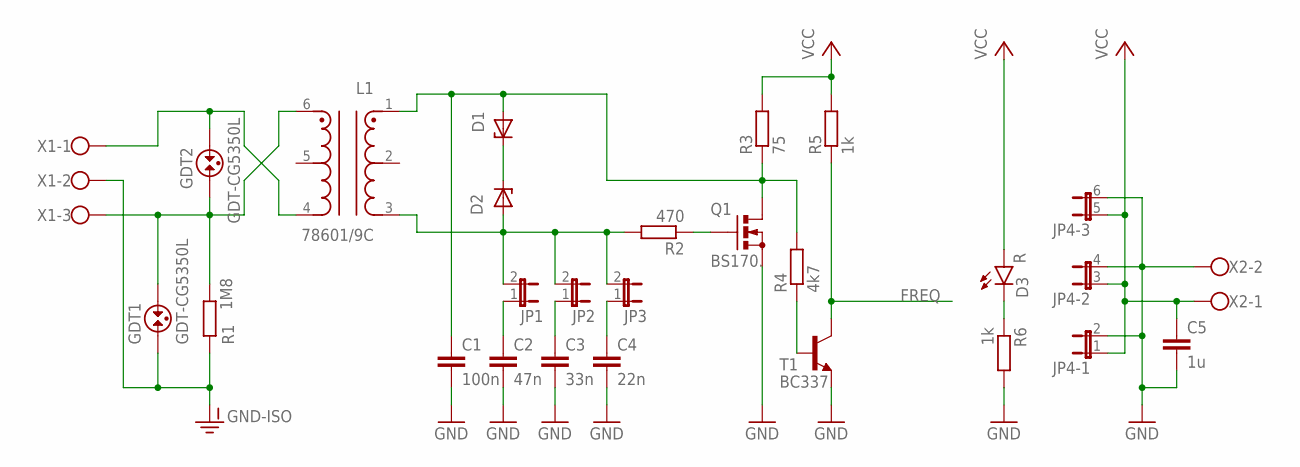
[picture p18: schematic detector_t85-pu.sch, sheet 1]

Parts:
C1: 100n; C050-024X044
C2: 47n; C050-024X044
C3: 33n; C050-024X044
C4: 22n; C050-024X044
C5: 1u; C050-025X075
D1, D2: 24V; ZDIO-5
D3: R; LED3MM
GDT1, GDT2: GDT-CG5350L; CG5350L
JP1, JP2, JP3: JUMPER-2PTH; 1X02
JP4: JP3QE; JP3Q
L1: 78601/9C
Q1: BS170.; TO92-DGS
R1: 1M8; 0204/5
R2: 470; 0204/5
R3: 75; 0204/7
R4: 4k7; 0204/5
R5, R6: 1k; 0204/5
T1: BC337; TO92-CBE
X1: W237-103
X2: W237-102

Connections:
FREQ: R5.1, T1.C; also elsewhere on the board
GND: C1.2, C2.2, C3.2, C4.2, C5.2, JP4.2, JP4.4 (2), JP4.6 (2), Q1.S, R6.2, T1.E, X2.2; also elsewhere on the board
GND-ISO: GDT1.1, R1.1, X1.2
unnamed: D1.C, D2.C
unnamed: R4.1, T1.B
unnamed: Q1.G, R2.1
unnamed: C3.1, JP2.1
unnamed: C4.1, JP3.1
unnamed: D2.A, JP1.2, JP2.2, JP3.2, L1.3, R2.2
unnamed: GDT2.2, L1.4, X1.1
unnamed: C2.1, JP1.1
unnamed: C1.1, D1.A, L1.1, Q1.D, R3.1, R4.2
unnamed: GDT1.2, GDT2.1, L1.6, R1.2, X1.3
unnamed: D3.K (C), R6.1
VCC: C5.1, D3.A, JP4.1, JP4.3 (1), JP4.5 (1), R3.2, R5.2, X2.1; also elsewhere on the board

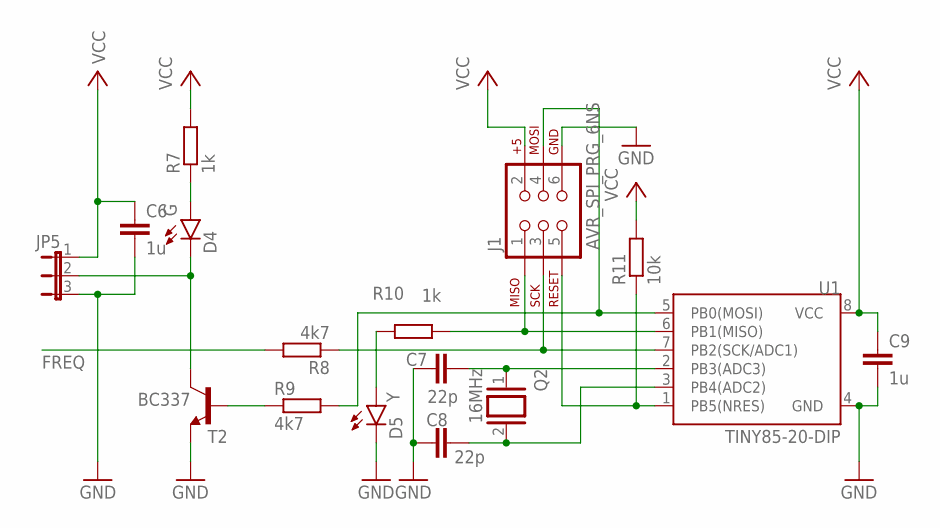
[picture p19: schematic detector_t85-pu.sch, sheet 2]

Parts:
C6, C9: 1u; C050-025X075
C7, C8: 22p; CAP-PTH-SMALL2
D4: G; LED3MM
D5: Y; LED3MM
J1: AVR_SPI_PRG_6NS; 2X3-NS
JP5: JP2E; JP2
Q2: 16MHz; QS
R7, R10: 1k; 0204/5
R8, R9: 4k7; 0204/5
R11: 10k; 0204/5
T2: BC337; TO92-CBE
U1: TINY85-20-DIP; DIP08

Connections:
FREQ: R8.2; also elsewhere on the board
GND: C6.2, C7.1, C8.1, C9.2, D5.K (C), J1.6, JP5.3, T2.E, U1.4 (GND); also elsewhere on the board
unnamed: R9.1, T2.B
unnamed: D4.K (C), JP5.2, T2.C
unnamed: D4.A, R7.1
unnamed: C7.2, Q2.1, U1.2 (PB3(ADC3))
unnamed: C8.2, Q2.2, U1.3 (PB4(ADC2))
unnamed: D5.A, R10.2
unnamed: J1.1, R10.1, U1.6 (PB1(MISO))
unnamed: J1.4, R9.2, U1.5 (PB0(MOSI))
unnamed: J1.5, R11.1, U1.1 (PB5(NRES))
unnamed: J1.3, R8.1, U1.7 (PB2(SCK/ADC1))
VCC: C6.1, C9.1, J1.2, JP5.1, R7.2, R11.2, U1.8 (VCC); also elsewhere on the board

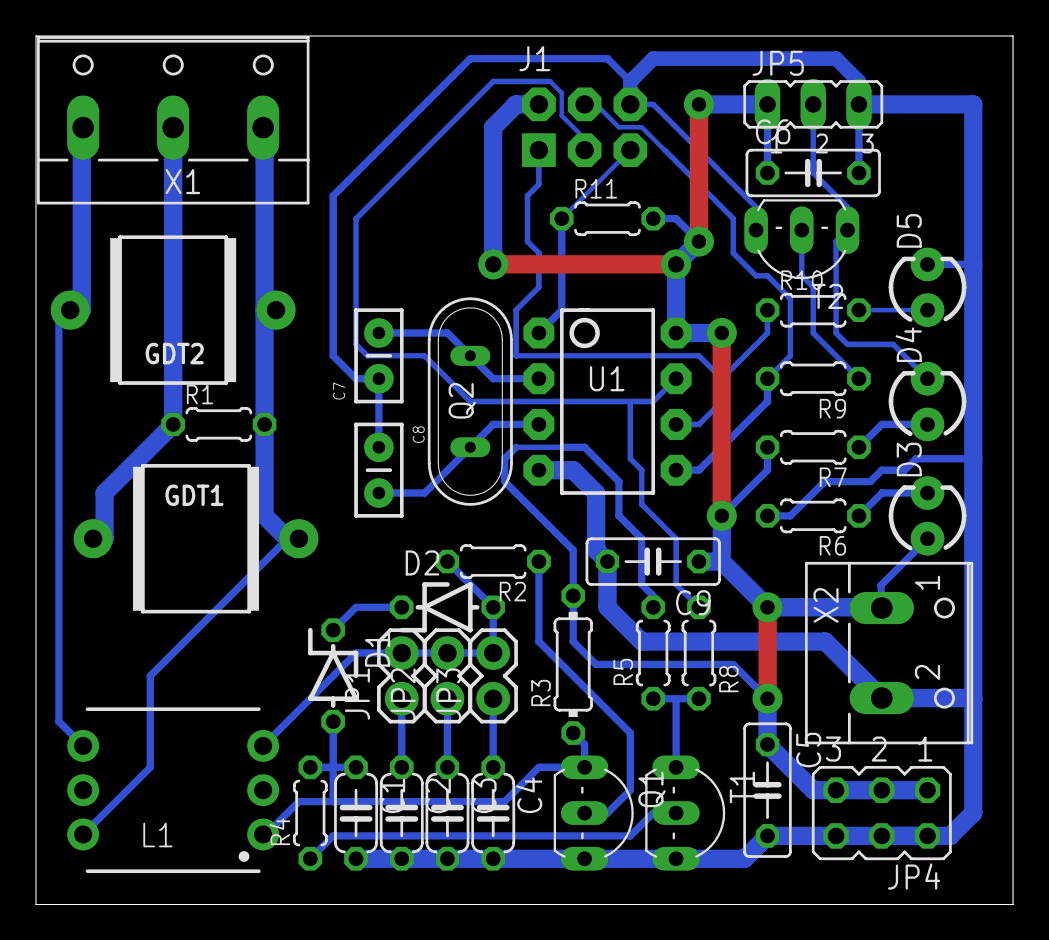
[picture p20: board detector_t85-pu.brd from above]

Board: 2 copper layers, 54.3 x 48.2 mm, 41 parts (0 on the bottom side), 25 nets.
