attilabody/cardetector/firmware/stm32/F030F4Px/Src/main.c

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

/* Includes ------------------------------------------------------------------*/
#include "main.h"
#include "i2c.h"
#include "iwdg.h"
#include "tim.h"
#include "usart.h"
#include "gpio.h"

/* USER CODE BEGIN Includes */
#include <config.h>
#include <globals.h>
#include <cardetector_common/detector.h>
#include <cardetector_common/display.h>
#include <stm32plus/usart.h>
#include <stm32plus/strutil.h>

#include <cardetector_common/liveconfig.h>
#include <cardetector_common/userinput.h>



/* USER CODE END Includes */


/* USER CODE BEGIN PV */

const char g_stateSyms[] = "-|+#*";

const LIVECONFIG g_config_default =
{
	  0xA5
	, {SHIFT_BELOW, SHIFT_BASE, SHIFT_ABOVE, SHIFT_ACTIVE, SHIFT_TIMEOUT}	//below, above, active, timeout
	, SHIFT_SUM		//shift
	, TIMELIMIT		//tlimit
	, DIVIDER		//divider
	, MCCOUNT		//mccntexp
	, 0
#if defined(USE_LEDBAR)
	, {
		{ 1, 2, 6, 0xe, 0x1e, 0x3e, 0x7e, 0xfe },
		{ 1, 2, 6, 0xe, 0x1e, 0x3e, 0x7e, 0xfe }
	  }
#endif
};

LIVECONFIG 	g_config;

// globals.h start /////////////////////////////////////////////////////////////
#ifdef USE_I2C
I2cMaster_State		*g_i2c;
#endif

#ifdef USE_EEPROM
I2cEEPROM_State		g_eeprom;
#endif

#ifdef USE_SERIAL
uint8_t				g_lineBuffer[64];
volatile uint8_t	g_lineReceived = 0;
#endif

/* USER CODE END PV */

void SystemClock_Config(void);
/* USER CODE BEGIN PFP */
void DisplayResults(uint8_t line);

/* USER CODE END PFP */

/* USER CODE BEGIN 0 */
#ifdef GENERATE_SWEEP
#define PWM_DELAY	2
#define PWM_STEP	1

//////////////////////////////////////////////////////////////////////////////
void HAL_SYSTICK_Callback(void)
{
	static uint16_t	counter = PWM_DELAY;
	static uint8_t	up = 1;
	static uint16_t	pwm = 0;

	//return;

	if(! --counter)
	{
		counter = PWM_DELAY;

		if(up) {
			if(pwm < htim14.Init.Period) {
				pwm += PWM_STEP;
			} else {
				pwm = htim14.Init.Period;
				up = 0;
			}
		} else {
			if(pwm > PWM_STEP) {
				pwm -= PWM_STEP;
			} else {
				pwm = 0;
				up = 1;
			}
		}
		__HAL_TIM_SetCompare(&htim14, TIM_CHANNEL_1, pwm);
	}
}
#endif	//	GENERATE_SWEEP

/* USER CODE END 0 */

/**
  * @brief  The application entry point.
  * @retval int
  */
int main(void)
{
  

  /* MCU Configuration--------------------------------------------------------*/

  /* Reset of all peripherals, Initializes the Flash interface and the Systick. */
  HAL_Init();

  /* Configure the system clock */
  SystemClock_Config();

  /* Initialize all configured peripherals */
  MX_GPIO_Init();
  MX_I2C1_Init();
  MX_TIM16_Init();
  MX_TIM17_Init();
  MX_USART1_UART_Init();
  /* USER CODE BEGIN 2 */
  g_config = g_config_default;

#ifdef USE_I2C
  g_i2c = I2cMaster_Init(&hi2c1);
  InitializeDisplay(g_i2c);
#endif

  MX_IWDG_Init();
  HAL_IWDG_Refresh(&hiwdg);

#ifdef USE_EEPROM
  I2cEEPROM_Init(&g_eeprom, g_i2c, EEPROMADDR, 1, 8);
  {
	LIVECONFIG	config;

	if(I2cEEPROM_Read(&g_eeprom, EESTART, &config, sizeof(config)) == HAL_OK) {
		I2cMaster_WaitCallback(g_i2c);
		if(config.magic == 0xA5)
			g_config = config;
	}
  }
#endif

#ifdef USE_SERIAL
  UsartInit(&huart1);
#endif	//	USE_SERIAL

#ifdef GENERATE_SWEEP
  HAL_TIM_Base_Start_IT(&htim14);
  HAL_TIM_PWM_Start(&htim14, TIM_CHANNEL_1);
  __HAL_TIM_SetCompare(&htim14, TIM_CHANNEL_1, 256);
#endif	//	GENERATE_SWEEP

  HAL_TIM_IC_Start_IT(&htim16, TIM_CHANNEL_1);
  HAL_TIM_IC_Start_IT(&htim17, TIM_CHANNEL_1);

#ifdef USE_SERIAL
  HAL_UART_Receive_IT(&huart1, g_lineBuffer, sizeof(g_lineBuffer));
#endif
  /* USER CODE END 2 */

  /* Infinite loop */
  /* USER CODE BEGIN WHILE */

  while (1)
  {
    /* USER CODE END WHILE */

    /* USER CODE BEGIN 3 */
#ifdef USE_SERIAL
	if(g_lineReceived)
	{
	  UsartSendStr((char*)g_lineBuffer, 1);
	  UsartSendStr("\r\n", 1);

	  ProcessInput(&g_config, (char*)g_lineBuffer);
	  //DisplayInput(&i2clcd);
	  g_lineReceived = 0;
	  HAL_UART_Receive_IT(&huart1, g_lineBuffer, sizeof(g_lineBuffer));
	}
#endif
	  if(g_statuses[0].trigger) {
		  DisplayResults(0);
		  g_statuses[0].trigger = 0;
	  }
	  if(g_statuses[1].trigger) {
		  DisplayResults(1);
		  g_statuses[1].trigger = 0;
	  }

	  HAL_IWDG_Refresh(&hiwdg);
  }
  /* USER CODE END 3 */
}

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
/* USER CODE BEGIN 4 */
////////////////////////////////////////////////////////////////////
#ifdef USE_SERIAL
void HAL_UART_RxCpltCallback(UART_HandleTypeDef *huart)
{
	if(huart == &huart1)
	{
		g_lineBuffer[sizeof(g_lineBuffer) - 1 - huart->RxXferCount] = 0;
		g_lineReceived = 1;
	}
}
#endif
////////////////////////////////////////////////////////////////////
void DisplayResults(uint8_t line)
{
	//TODO: optimize
#if defined(DEBUG_SERIAL) || defined(USE_LCD)
	uint8_t			irqEnabled = __get_PRIMASK() == 0;
	__disable_irq();
	DETECTORSTATUS	st = g_statuses[line];
	if(irqEnabled) __enable_irq();
#endif

#if defined(DEBUG_SERIAL)
	if(g_config.debug & (line+1))
	{
		// 1: | 20CDC000, 8336, 8337,         1,    10,        41,       1
		//ch st sum,      avg,  lastMeasured, diff, tolerance, threshold correction
		UsartPrintUint(line, 0, 1);
		UsartSend(": ", 2, 1);
		UsartSend(&g_stateSyms[st.state], 1, 1);
		UsartSend(" ", 1, 1);
		UsartPrintUint(st.sum, -1, 1);
		UsartSend(", ", 2, 1);
		UsartPrintUint(st.avg, -1, 1);
		UsartSend(", ", 2, 1);
		UsartPrintUint(st.lastMeasured, -1, 1);
		UsartSend(", ", 2, 1);
		UsartPrintInt(st.diff, 0, 1);
		UsartSend(", ", 2, 1);
		UsartPrintUint(st.tolerance, 0, 1);
		UsartSend(", ", 2, 1);
		UsartPrintUint(st.threshold, 0, 1);
		UsartSend(", ", 2, 1);
		UsartPrintInt(st.correction, 0, 1);
		UsartSend("\r\n", 2, 1);
	}
#endif	//	DEBUG_SERIAL

#if defined(USE_LCD)
#if defined(DEBUG_LCD)
	I2cLcd_SetCursor(&g_lcd, 0, line);
	I2cLcd_PrintChar(&g_lcd, g_stateSyms[st.state]);
	I2cLcd_PrintChar(&g_lcd, ' ');
	I2cLcd_PrintInt(&g_lcd, st.diff, 0);
	I2cLcd_PrintStr(&g_lcd, "   ");
#else
	if(g_config.debug & 4) {
		uint32_t freq = ((uint32_t)((uint64_t)48000000*64 / st.lastMeasured));
		I2cLcd_SetCursor(&g_lcd, 0, line);
		I2cLcd_PrintUint(&g_lcd, freq, 0);
	}
#endif	//	DEBUG_LCD

#endif	//	USE_LCD

#if defined(USE_LCD) || defined(USE_LEDBAR)
	UpdateBar(line, CalcBar(&st));
#endif
}

/* USER CODE END 4 */
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
