attilabody/cardetector/firmware/stm32/F103C8Tx/Inc/main.h

#define ACTIVE1_Pin GPIO_PIN_14
#define ACTIVE1_GPIO_Port GPIOC
#define ACTIVE2_Pin GPIO_PIN_15
#define ACTIVE2_GPIO_Port GPIOC
#define OSC1_Pin GPIO_PIN_0
#define OSC1_GPIO_Port GPIOA
#define OSC2_Pin GPIO_PIN_2
#define OSC2_GPIO_Port GPIOA
#define LD11_Pin GPIO_PIN_3
#define LD11_GPIO_Port GPIOA
#define LD12_Pin GPIO_PIN_4
#define LD12_GPIO_Port GPIOA
#define LD13_Pin GPIO_PIN_5
#define LD13_GPIO_Port GPIOA
#define LD14_Pin GPIO_PIN_6
#define LD14_GPIO_Port GPIOA
#define LD15_Pin GPIO_PIN_7
#define LD15_GPIO_Port GPIOA
#define LD16_Pin GPIO_PIN_0
#define LD16_GPIO_Port GPIOB
#define LD17_Pin GPIO_PIN_1
#define LD17_GPIO_Port GPIOB
#define LD18_Pin GPIO_PIN_2
#define LD18_GPIO_Port GPIOB
#define LD21_Pin GPIO_PIN_10
#define LD21_GPIO_Port GPIOB
#define LD22_Pin GPIO_PIN_11
#define LD22_GPIO_Port GPIOB
#define LD23_Pin GPIO_PIN_12
#define LD23_GPIO_Port GPIOB
#define LD24_Pin GPIO_PIN_13
#define LD24_GPIO_Port GPIOB
#define LD25_Pin GPIO_PIN_14
#define LD25_GPIO_Port GPIOB
#define LD26_Pin GPIO_PIN_15
#define LD26_GPIO_Port GPIOB
#define LD27_Pin GPIO_PIN_8
#define LD27_GPIO_Port GPIOA
#define LD28_Pin GPIO_PIN_11
#define LD28_GPIO_Port GPIOA
