attilabody/cardetector/firmware/stm32/F030F4Px/Inc/main.h

#define T14_RELOAD 500
#define ACTIVE1_Pin GPIO_PIN_5
#define ACTIVE1_GPIO_Port GPIOA
#define OSC1_Pin GPIO_PIN_6
#define OSC1_GPIO_Port GPIOA
#define OSC2_Pin GPIO_PIN_7
#define OSC2_GPIO_Port GPIOA
#define ACTIVE2_Pin GPIO_PIN_1
#define ACTIVE2_GPIO_Port GPIOB
