attilabody/cardetector/(commit log)

2016-05-14 using timer0 instead of timer1
2016-05-16 serial code embedded only when absolutely necessary; params struct, function provided to read them from eeprom timelimit interpreted in seconds (4 samples) instead of samples
2016-05-18 Pins and timers selected in config.h (cardetector.c became model independent) Separate pin for signaling and LED
2016-05-29 detector shamatics added
    [detector.sch]
2016-05-29 hardware: replaced impulse transformer, VCC capacitors added
    [detector.sch]
2016-05-29 fixing TIFR T0 overflow interrupt pending bit reset (0->1)
    [cardetector.c, config.h]
2016-06-02 hardware: separate pages for analog and digital part, separate schematics for tiny85 and mega328p
    [detector328p.sch]
2016-06-02 hardware: separate DIP and SIL drawings for mega328p, gitignore tuning
    [detector.sch, detector328p-pu.sch]
2016-06-02 hardware: renamed schs to reflect the CPU (variant) used.
    [detector328p-au.sch, detector_t85-pu.sch]
2016-06-02 hardware: t85 all parts on the board
    [detector_t85-pu.brd, detector_t85-pu.sch]
2016-06-02 hardware: t85 board fuckery
    [detector_t85-pu.brd, detector_t85-pu.sch]
2016-06-02 hardware-t85: almost there
    [detector_t85-pu.brd, detector_t85-pu.sch]
2016-06-03 hardware-t85: really almost there
    [detector_t85-pu.brd, detector_t85-pu.sch]
2016-06-04 hardware-m328p-au: preparing schematics for board creation
    [detector328p-au.sch]
2016-06-05 hardware-m328p-pu: board created
    [detector328p-pu.brd, detector328p-pu.sch]
2016-06-05 hardware-m328p-au: MCU referred from gate433.lbr
    [detector328p-au.sch]
2016-06-05 hardware-328p-au: more smt replacements
    [detector328p-au.sch]
2016-06-08 Board level 0
    [detector328p-au.brd, detector328p-au.sch]
2016-06-10 detector328p-au level 1: devices at place
    [detector328p-au.brd, detector328p-au.sch]
2016-06-11 detector328p-au almost wired
    [detector328p-au.brd, detector328p-au.sch]
2016-06-11 detector328p-au wiring ready, labels need fixing
    [detector328p-au.brd, detector328p-au.sch]
2016-06-11 detector328p-au final
    [detector328p-au.brd, detector328p-au.sch]
2016-06-11 detector328p-au serial port
    [detector328p-au.brd, detector328p-au.sch]
2016-06-11 detector328p-au R2->1K, T1->BC817
    [detector328p-au.brd, detector328p-au.sch]
2016-06-12 hardware: eagle files moved from hardware/ to hardware/eagle/ .gitignore prepared for kicad files
    [detector328p-au.brd, detector328p-au.sch, detector328p-pu.brd, detector328p-pu.sch, detector_t85-pu.brd, detector_t85-pu.sch]
2016-06-19 cardetector: i2c handler, dead code elimination
2016-06-22 cardetector: i2c LCD
2016-06-25 Interrupt driven serial communication proto
2016-07-02 hardware/kicad/328p-au: schematic created
    [cardetector_328p-au.kicad_pcb, cardetector_328p-au.sch]
2016-07-02 hardware/kicad/328p-au: separated output sheet
    [cardetector_328p-au.sch, output.sch]
2016-07-02 hardware/kicad/328p-au: separated collpits page, footprints assigned and imported to PCB
    [cardetector_328p-au.kicad_pcb, cardetector_328p-au.sch, colpitts.sch, output.sch]
2016-07-02 hardware/kicad/328p-au: use 3x2 jumper block for frequency selection
    [cardetector_328p-au.kicad_pcb, cardetector_328p-au.sch, colpitts.sch, output.sch]
2016-07-02 hardware/kicad: added serial connector && 3 push buttons
    [cardetector_328p-au.kicad_pcb, cardetector_328p-au.sch, colpitts.sch, output.sch]
2016-07-10 cardetector: refactoring, led bar implementation
2017-01-22 added stm32 firmware
2017-01-23 hardware/kicad/stm32f030: created
    [colpitts.sch, ledbar.sch, mcu.sch, outputs.sch, stm32f030.kicad_pcb, stm32f030.sch]
2017-01-24 hardware/kicad/stm32f030: progress
    [colpitts.sch, ledbar.sch, mcu.sch, outputs.sch, stm32f030.kicad_pcb, stm32f030.sch]
2017-01-28 hardware/kicad/stm32f030: modules ready
    [ledbar.sch, mcu.sch, outputs.sch, stm32f030.kicad_pcb]
2017-01-30 stm32 debugger config
    [GENERIC-FTM32F030F4Px.cfg]
2017-01-31 slight;y modified module layout
    [stm32f030.kicad_pcb]
2017-01-31 more optimizations on modules
    [stm32f030.kicad_pcb]
2017-01-31 space for mounting hole
    [stm32f030.kicad_pcb]
2017-02-02 PCB V0.90
    [mcu.sch, stm32f030.kicad_pcb]
2017-02-02 hardware/kicad: all LED IDs moved to the board area and made visible
    [stm32f030.kicad_pcb]
2017-02-09 hardware/kicad/stm32f030: adding eeprom step1
    [colpitts.sch, eeprom.sch, ledbar.sch, mcu.sch, outputs.sch, stm32f030.kicad_pcb, stm32f030.sch]
2017-02-09 hardware/kicad/stm32f030: adding eeprom step2
    [colpitts.sch, eeprom.sch, outputs.sch, stm32f030.kicad_pcb, stm32f030.sch]
2017-02-10 hardware/kicad/stm32f030: adding eeprom step3
    [colpitts.sch, eeprom.sch, ledbar.sch, mcu.sch, outputs.sch, stm32f030.kicad_pcb, stm32f030.sch]
2017-02-13 hardware/kicad/stm32f030: final touches
    [colpitts.sch, outputs.sch, stm32f030.kicad_pcb, stm32f030.sch]
2017-02-14 hardware/kicad/stm32f030: i2c eeprom pad widening
    [stm32f030.kicad_pcb]
2017-02-14 firmware/stm32: moved component initialization codes to separate c/h files
2017-02-14 firmware/stm32 f030f4Px firmware code moved to separate subfolder
    [GENERIC-FTM32F030F4Px.cfg]
2017-02-14 hardware/kicad/stm32f030: use upper layer zones for power
    [stm32f030.kicad_pcb]
2017-02-15 hardware/kicad: cardetector.pretty moved from stm32f030 to ..
2017-02-15 hardware/kicad: stm32f103 created (stm32f030 copy)
    [colpitts.sch, eeprom.sch, ledbar.sch, mcu.sch, outputs.sch, stm32f103.kicad_pcb, stm32f103.sch]
2017-02-19 hardware/kicad/stm32f103: MCU/LED block ready
    [colpitts.sch, eeprom.sch, ledbar.sch, mcu.sch, outputs.sch, stm32f030.kicad_pcb, stm32f103.kicad_pcb, stm32f103.sch]
2017-02-21 hardware/kicad/stm32f103: Almost there...
    [stm32f103.kicad_pcb]
2017-02-23 hardware/kicad/stm32f103: Minor cosmetic changes
    [eeprom.sch, mcu.sch, stm32f103.kicad_pcb]
2017-02-23 hardware/kicad/stm32f030: Ledbar removed, reorg started
    [eeprom.sch, ledbar.sch, mcu.sch, stm32f030.kicad_pcb, stm32f030.sch]
2017-02-25 hardware/kicad/stm32f030: blocks ready
    [colpitts.sch, eeprom.sch, mcu.sch, outputs.sch, stm32f030.kicad_pcb, stm32f030.sch]
2017-02-28 hardware/kicad/stm32f030: everything is connected, DRC OK
    [colpitts.sch, eeprom.sch, mcu.sch, outputs.sch, stm32f030.kicad_pcb, stm32f030.sch]
2017-03-01 hardware/kicad/stm32f030: removed derecated libraries
    [colpitts.sch, eeprom.sch, mcu.sch, outputs.sch, stm32f030.sch]
2017-03-01 firmware/stm32/F103C8Tx firmware added
2017-03-05 firmware/stm32: renamed 103 and 030 projects
2017-03-05 firmware/stm32: i2cmaster, pcf8574, i2clcd added to cardetector_common
2017-03-05 hardware/kicad/stm32f030: changed i2c bus and eeprom voltage to 5V
    [eeprom.sch, mcu.sch, stm32f030.kicad_pcb]
2017-03-05 firmware/stm32/f030f4px: i2clcd and usart send test
    [GENERIC-STM32F030F4Px.cfg]
2017-03-11 firmware/stm32/f030f4px: detection working
2017-03-12 firmware/stm32/cardetector_common fixes and improvements
    [i2ceeprom.c, i2clcd.c, i2cmaster.c, pcf8574.c, pcf8574.h]
2017-03-12 firmware/stm32 cardetector_common renamed to stm32plus, i2cmaster modularized i2ceeprom seems to work
2017-03-14 firmware/stm32/stm32plus: removed m_ prefixes, optimized i2clcd init
2017-03-17 firmware/stm32/F030F4Px Almost feature complete (only MCP23017 led bar missing, pcf8574 led bar untested)
    [config.h, display.c, globals.h, main.c]
2017-09-22 firmware/stm32/F030F4Px migrated to new cube && sw4stm32 versions iwdg switched on (code still should be written to work)
2017-09-22 firmware/stm32/F030F4Px: fine-tuning USE_ flag usage
2017-09-22 hardware/kicad/stm32f030: kicad version && lib bump
    [colpitts.sch, eeprom.sch, mcu.sch, outputs.sch, stm32f030.kicad_pcb, stm32f030.sch]
2017-09-27 stm32f030 PCB text fixes
    [stm32f030.kicad_pcb]
2017-09-28 Atmel firmware serial buffer size (theoretical) bug fix
    [serial.c]
2017-10-01 st: various minor fixes
    [config.h, display.c, globals.h]
2017-10-02 barechip-F030F4Px added (board test)
    [barechip-F030F4Px Debug.cfg]
2017-10-03 kicad/stm32f030: corrected board size
    [stm32f030.kicad_pcb]
2017-10-06 firmware/stm32/barechip-F030F4Px chagnes
2017-10-06 STM32F030F4Px firmware adoption to proto board implementation
2017-10-08 Made lcd/ledbar mutually exclusive again (too much effort to make them work parallel and would not fit to 030f4
    [config.h, display.c, globals.h, userinput.c]
2017-10-08 ledbar values from config
2017-10-23 STM32f030F4Px V0.99
    [cardetector-F030F4Px Debug.cfg, cardetector-F030F4Px Run.cfg]
2017-10-23 kicad-STM32F030 modifications during test batch assembly
    [colpitts.sch, stm32f030.kicad_pcb]
2017-12-05 checked in last state of firmware/stm32/barechip test project
    [barechip-F030F4Px Run.cfg]
2018-01-26 stm32plus: extern "C" into the headers for mixed projects
2018-01-26 STM32F030F4Px: copied Drivrers/uart.c into Application folder to protect from overwriting by CubeMX
2019-07-20 Rebuilt project structure
    [GENERIC-FTM32F030F4Px.cfg, GENERIC-STM32F030F4Px.cfg, cardetector-F030F4Px Debug.cfg]
