attilabody/cardetector/(notices)

Notices in the files:
firmware/stm32/F103C8Tx/Inc/main.h:
COPYRIGHT(c) 2017 STMicroelectronics
(C) COPYRIGHT STMicroelectronics *****END OF FILE
firmware/stm32/F030F4Px/Inc/main.h:
© Copyright (c) 2019 STMicroelectronics.
All rights reserved.
This software component is licensed by ST under BSD 3-Clause license,
the "License"; You may not use this file except in compliance with the
License. You may obtain a copy of the License at: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
parts and their libraries:
SparkFun-Retired: Licensing:Creative Commons ShareAlike 4.0 International - https://creativecommons.org/licenses/by-sa/4.0
supressor: Copyright (C) 2009, Bob Starr
